ka5j/obd2-sniffer/docs/design/testing.md

# Testing and code coverage

Part of the [project documentation](../README.md).

## In short

Every change to this project is tested automatically before it can be merged. The logic that
doesn't depend on the microcontroller's hardware (data buffers, message encoding, the console,
the diagnostic protocol) is written so it can also run on a normal computer, where it is checked
by unit tests.

Those tests must reach **100% MC/DC coverage**, or the change is rejected. MC/DC is the coverage
standard used for flight-control software (DO-178C) and recommended for the highest safety level
of automotive software (ISO 26262 ASIL D). It means that for every decision in the code, each
condition in it was shown to change the outcome on its own. The tests also run under tools that
detect memory errors, undefined behaviour and race conditions between threads.

All C code is also checked against the MISRA C:2012 coding standard; see [misra.md](misra.md).
The firmware's worst-case stack use is worked out from each build and must fit the reserved
stack; see [build-and-boot.md](build-and-boot.md#memory-layout).

Results are published automatically:

- **Live report:** <https://ka5j.github.io/obd2-sniffer/>, with every test and the line-by-line
  coverage, updated on each merge
- **Pull requests:** each test appears in the checks tab, and a coverage table is added to the
  build summary

## What gets tested where

| Code | Runs on | How it is tested |
|---|---|---|
| Portable core (`lib/`): buffers, encoding, console logic, CAN timing, ISO-TP and OBD2 | Laptop and CI | Unit tests, 100% MC/DC required |
| Hardware drivers (`firmware/`): clocks, UART, CAN, watchdog | The STM32 board | On the board: `scripts/board_check.py`, deliberate crashes, and checks by hand |
| Laptop tool (`host/`) | Laptop and CI (Python 3.10 and 3.12) | Python tests (pytest), 100% line and branch coverage required, plus lint (ruff) |

Keeping hardware-specific code thin, and moving every decision that can be moved into the portable
core, is what makes the high coverage target practical.

The laptop tool is tested against a software model of the board's console (`host/src/obdsniff/sim/board.py`)
and against scripted fake connections for the failure cases: no reply, malformed replies, a
board that doesn't come back after a restart, a release build that rejects test commands. The
desktop app is tested the same way with pytest-qt: the real window is clicked through against the
simulator, drawing offscreen so it runs in CI without a display. Python has no MC/DC tooling, so
it is held to 100% line and branch coverage instead.

## Checks on the board

Code that drives the hardware can only be proven on the hardware. It is checked on a real
NUCLEO-F446RE board. Each release is checked this way before it is tagged.

Most checks are scripted in `scripts/board_check.py`. It drives the board through the laptop
tool's library and prints one line per check with the number it measured, so anyone with a board
can repeat the results below:

```sh
python3 scripts/board_check.py            # finds the board; about 75 s
python3 scripts/board_check.py --crash    # also the crash and watchdog checks (restarts the board)
python3 scripts/board_check.py --quick    # fewer frames, shorter waits; about 20 s
```

The latest run, on 2 November 2026, of CI's release file for v0.5.0, **Debug build**, flashed
onto the board by `scripts/release_check.py --flash debug`, with `--crash`:

```
Board check on /dev/cu.usbmodem11303
PASS  Identity        firmware v0.5.0, debug build, STM32F446RE rev 0x1000
PASS  Clocks          168 MHz from HSE 8 MHz bypass
PASS  Watchdog        500 ms nominal
PASS  Clock accuracy  -14 ppm against the laptop over 20 s (limit 1000)
PASS  Command burst   100 commands sent at once: 100 replies, 0 errors, nothing dropped; 26.9 KB in 180 ms (99% of the line rate)
PASS  CAN safety      with CAN off, 2 of 2 transmit commands refused; no command sends a frame by hand
PASS  CAN capture     100,000 frames at 500 kbit/s: 0 lost, 0 wrong, 0 damaged; 4,230 frames/s (a full bus gives at least 3,704)
PASS  CAN capture     10,000 frames at 250 kbit/s: 0 lost, 0 wrong, 0 damaged; 2,097 frames/s (a full bus gives at least 1,852)
PASS  CAN overload    20,000 frames at 1000 kbit/s: 2,444 lost; board counted 2,444 dropped and 0 overruns, laptop saw 2,444 missing capture numbers
PASS  OBD2            201 requests in 10 s (20.0/s, 15 to 20), 0 refused by the guard: 201 replies, 0 timeouts, 0 errors; VIN right, trouble codes right; then silent when not asked
PASS  CAN interrupt   longest receive interrupt 10 us (limit 47)
PASS  Commands + CAN  2,601 commands while 42,131 frames arrived at 500 kbit/s: 0 failed, 0 bytes lost to receive overruns
PASS  Reset           after `reset`: last reset software
PASS  Crash capture   `crash bus`: BusFault (bus error on data access) at 0x08002066
PASS  Crash capture   `crash usage`: UsageFault (unaligned memory access) at 0x08002172
PASS  Crash capture   `crash divzero`: UsageFault (divide by zero) at 0x0800219C
PASS  Crash capture   `crash hard`: HardFault (bus error on data access) at 0x08002066
PASS  Watchdog        main loop stopped: last reset independent watchdog
18 checks: all passed.
```

CI's **Release build** passed the same day, with three differences:

- **CAN overload:** 5,209 of 20,000 frames lost (the Debug build: 2,444), every one counted on
  the board and seen as a gap on the laptop. The test traffic comes from the same main loop that
  streams it, and only the optimised Release build keeps a 1 Mbit/s bus full while streaming, so
  overload numbers are quoted from the Release build.
- **CAN interrupt:** 6 µs at most, against 10 µs in the Debug build.
- **Crash command:** absent, as it should be; 14 checks in all.

The locally built tag passed the same checks before it was pushed (Release 14 of 14, Debug 18 of
18).

CI runs the same script against the simulator (`--port sim`) on every change, so it keeps working
as the code changes. The rest (the button, the LED, the desktop app, timing the watchdog) is
checked by hand.

**Latest full checks by hand:** 19 and 20 October 2026, for v0.4.0, Debug and Release builds,
serial link at 1.5 Mbaud. v0.4.1 changed no firmware behaviour, so for it, on 28 October 2026,
only `obdsniff can test`, `obdsniff obd watch` and the desktop app's console, CAN and OBD2 tabs
were repeated by hand, all passing. For v0.5.0, on 2 November 2026, the desktop app's three tabs
were driven on the board by `scripts/screenshots.py` (connect, `help`, `crash bus`, 10,000 test
frames, about 100 OBD2 questions), all as expected. The button, the LED heartbeat and the
watchdog's timing by stopwatch were not repeated by hand for v0.5.0.

| Area | Check | Result |
|---|---|---|
| Clocks | Start-up report shows the external 8 MHz clock, 180 MHz CPU, 45 and 90 MHz buses | Pass |
| Clocks | Board uptime against the laptop's clock over 20 s | Pass: +15 ppm, within the resolution of the measurement (1 ms in 20 s, 50 ppm). The internal oscillator would be off by up to 1% (10,000 ppm) |
| Serial console | Every command and error message; Backspace, Ctrl-C, the 96-character limit | Pass |
| Serial console | The reply to `reset` arrives complete before the board restarts | Pass |
| Serial console | Bursts of commands sent without waiting: 20 and 50 at 115200 baud, 100 at 1.5 Mbaud (28 KB at 99% of the line rate). Every reply intact, nothing dropped, no restart | Pass |
| Serial console | Commands sent continuously while the CAN bus is full (500 kbit/s): 2,693 commands as 42,129 frames arrived, none failed, no received byte lost | Pass |
| Button and LED | Button presses reported in both modes, with a half-typed line shown again; LED heartbeat | Pass |
| Crash capture | `crash bus`, `usage`, `divzero`, `hard`: right fault type and cause after the restart; the saved code address points at the faulting line (`fault.c:87` for `bus`); bad address `0x08080000` | Pass |
| Watchdog | Main loop stopped on purpose: reset after 535 ms (allowed: 340 to 940 ms), reported as a watchdog reset | Pass |
| Reset causes | Software reset, watchdog and reset pin each reported correctly | Pass |
| Release build | The `crash` test command is absent; everything else works | Pass |
| Laptop tool | Board found by its USB IDs; `info`, `--json status`, `led`, `shell` reconnecting after `reset` and `crash` | Pass |
| Desktop app | Connect, board details, console commands, `crash bus` then clear the record; the window keeps responding while the board restarts; the board is handed back in interactive mode on exit | Pass |
| Serial link | Stress test at 921,600, 1,000,000, 1,500,000 and 2,250,000 baud: every reply intact, about 99% of the line rate, no errors; 1.5 Mbaud chosen ([serial-console.md](serial-console.md#speed)) | Pass |
| CAN capture | Silent loopback, every frame checked by number and content: 100,000 frames at 500 kbit/s (4,230 frames/s, 100% load) and 10,000 at 250 kbit/s, none lost or damaged; frame spacing matches the frame length on the bus | Pass |
| CAN capture | 1 Mbit/s overload: frames dropped on the board when the serial link can't keep up, and the laptop sees exactly that many gaps in the capture numbers | Pass |
| CAN capture | Longest receive interrupt: 7 µs | Pass |
| CAN capture | Streaming off (`can stream off`): no frame lines in a terminal during 1,000 test frames, all of them received and counted. At 1 Mbit/s and 100% load, 20,000 frames received and none dropped: the serial link is the only limit | Pass |
| OBD2 | Tester and simulated ECU over loopback, in a serial terminal: refused with CAN off; after 2 s, 220 requests and 220 replies; VIN (a multi-frame reply), both trouble codes and the warning light right; live values follow the simulated drive; about 95 requests a second; 0 timeouts, 0 errors, 0 frames dropped; longest receive interrupt 10 µs. Now also scripted in `board_check.py` | Pass |
| CAN tools | `can test`, `monitor --log` (candump file), shell; desktop-app CAN tab: 4,000 test frames shown, none lost; a second program can't open the port | Pass |

The checks found problems that the unit tests and the simulator had not, all fixed:

- A line longer than 96 characters was cut short and then run as a command. It is now rejected
  whole ([#16](https://github.com/ka5j/obd2-sniffer/pull/16)).
- The laptop tool left the board in host mode, so a serial terminal opened afterwards showed no
  prompt or echo ([#15](https://github.com/ka5j/obd2-sniffer/pull/15)).
- In `help` and `fault` output, the longest entries were out of alignment
  ([#16](https://github.com/ka5j/obd2-sniffer/pull/16)).
- A burst of commands (for example pasted into a terminal) ran in a single pass of the main loop.
  At 115200 baud the replies took over a second to send, so the watchdog restarted the board; with
  that fixed, replies were partly dropped because the transmit buffer freed space only in large
  steps. Commands now run one per pass, only when their reply fits, and DMA transfers are capped at
  256 bytes ([#24](https://github.com/ka5j/obd2-sniffer/pull/24)).
- At 1.5 Mbaud the laptop tool got no replies, although a hand-written test worked. Changing any
  serial setting makes pyserial re-apply them all, and on macOS 1.5 Mbaud is applied through a
  placeholder speed, so every read briefly switched the ST-LINK's speed and lost bytes. The port is
  now configured once ([#26](https://github.com/ka5j/obd2-sniffer/pull/26)).
- Frame sequence numbers were first given when frames were sent, so frames dropped on the board
  left no gap. The overload test showed no gaps while thousands of frames were lost. They are now
  numbered on arrival ([#29](https://github.com/ka5j/obd2-sniffer/pull/29)).
- Two programs could open the board's port at once and split its output between them. The laptop
  tool now opens it exclusively ([#30](https://github.com/ka5j/obd2-sniffer/pull/30)).
- With OBD2 running, about one command in 200 from the desktop app was rejected as an unknown
  command. Bytes were being lost on the way in: the board counted receive overruns, and only
  while CAN traffic ran. At 1.5 Mbaud the UART must be read within 6.7 µs of each byte, but the
  CAN receive interrupt, which then had the higher priority, can run for 7 to 10 µs. Interrupt
  priorities now follow deadlines, with the serial receive interrupt first. 20 s of commands
  during OBD2 traffic went from 11 overruns and 15 failed commands to none, and the board check
  now sends commands while the bus is full ([#46](https://github.com/ka5j/obd2-sniffer/pull/46)).

## Coverage measures

| Measure | Meaning |
|---|---|
| Lines | Every line ran in at least one test |
| Functions | Every function was called |
| Regions | Every block of code ran, including each part of a short-circuit expression |
| Branches | Every decision went both ways (true and false) |
| MC/DC | Every condition in a decision independently changed the decision's outcome |

Example: `if (rb == NULL || storage == NULL || capacity < 2 || !power_of_two)`. Branch coverage
only needs one test that rejects and one that accepts. MC/DC needs a test for each of the four
conditions, where only that condition is true and it alone causes the rejection. That proves
every check is actually needed and actually works.

## Engineering detail

### Tools

- **Unity**: a small C unit-test framework, fetched by CMake at a pinned version.
- **CTest**: CMake's test runner. Every Unity test function is registered as its own CTest test
  (`ring_buffer.test_counters_wrap_past_uint32_max`), so each case is reported individually.
  Unity's default `RUN_TEST` ignores the name filter, so the tests use a `UNIT_TEST()` wrapper
  that applies it (`tests/test_support.h`).
- **Clang source-based coverage** with `-fcoverage-mcdc` (Clang 18 or newer).
  `scripts/coverage.py` merges the results, writes the HTML report, and fails the build if any of
  the five measures is below 100%.
- **Sanitizers** on every test run:
  - *AddressSanitizer*: out-of-bounds access, use-after-free
  - *UndefinedBehaviorSanitizer*: integer overflow, misaligned access, invalid shifts
  - *ThreadSanitizer*: data races. This matters for the lock-free ring buffer, whose stress test
    runs a producer and a consumer thread at full speed.

  Any sanitizer finding stops the test immediately (`-fno-sanitize-recover=all`).

### Checking the checks

A test suite is only useful if it can fail, so each guard was verified by breaking the code on
purpose:

- **Coverage gate:** when it was introduced (the library then held only the ring buffer), skipping
  the one test of `ring_init`'s argument checks dropped MC/DC to 0% and branch coverage to 80%, and
  the gate failed.
- **ThreadSanitizer:** weakening the ring buffer's memory ordering from release/acquire to relaxed
  makes the CI run report `data race ... in memcpy`.
- **Name filter:** a test name that matches nothing makes Unity report "0 Tests", which CTest
  treats as a failure.

ThreadSanitizer is checked on Linux in CI. On current macOS it misses even a textbook race, so a
local pass there is not taken as evidence.

### Running locally

```sh
# Unit tests with AddressSanitizer + UndefinedBehaviorSanitizer (configure, build, run)
cmake --workflow --preset host-tests

# Coverage report (Clang 18+), opens build/host-coverage/report/coverage/index.html
cmake --preset host-coverage && cmake --build --preset host-coverage
ctest --preset host-coverage && python3 scripts/coverage.py

# Report site as published on GitHub Pages
python3 scripts/build_report_site.py --out build/site \
    --junit "C unit tests=build/host-coverage/junit-c.xml" \
    --coverage "C core library=build/host-coverage/report"
```
