ka5j/obd2-sniffer/hardware/rev-a/obd2-sniffer-rev-a.pdf

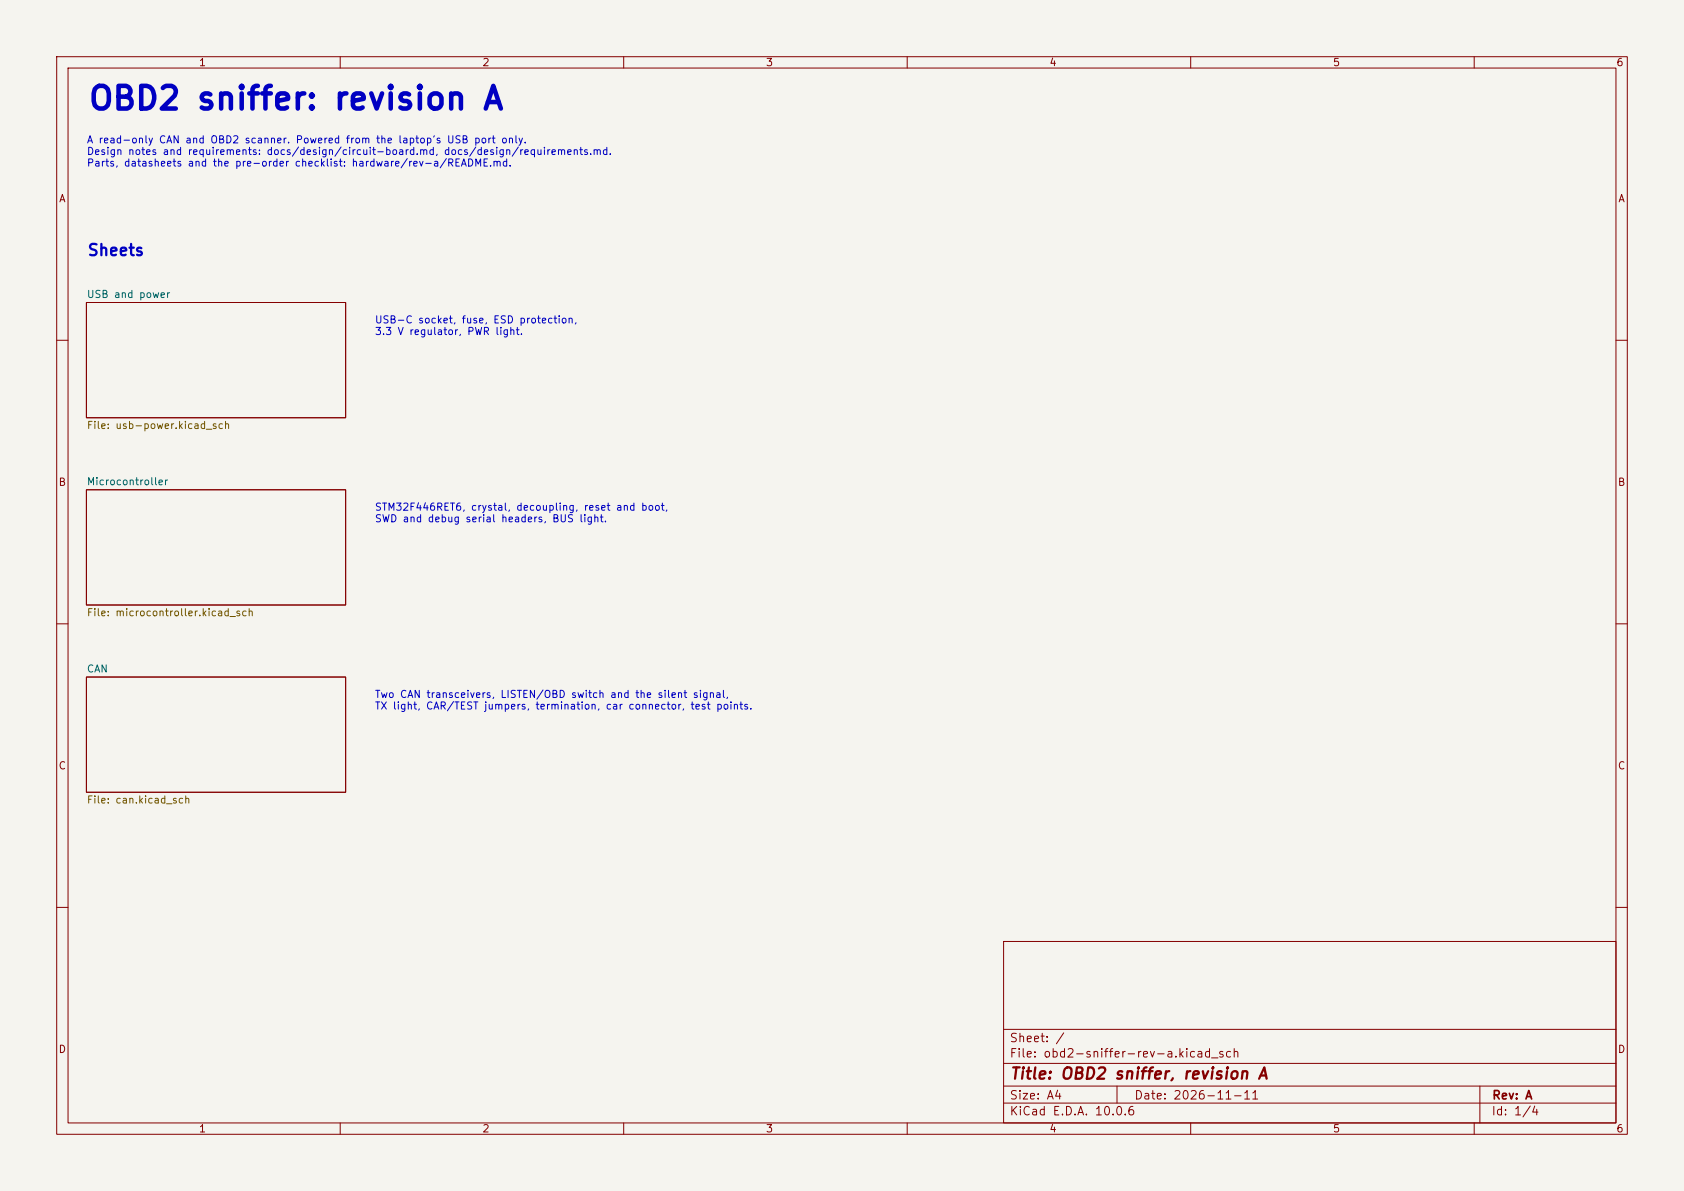
[picture p5: page 1]

USB and power File: usb-power.kicad_sch CAN

A read-only CAN and OBD2 scanner. Powered from the laptop's USB port only.
Design notes and requirements: docs/design/circuit-board.md, docs/design/requirements.md.
Parts, datasheets and the pre-order checklist: hardware/rev-a/README.md.

STM32F446RET6, crystal, decoupling, reset and boot, SWD and debug serial headers, BUS light. Two CAN transceivers, LISTEN/OBD switch and the silent signal, TX light, CAR/TEST jumpers, termination, car connector, test points.

Size: A4 | Rev: A
KiCad E.D.A. 10.0.6 | Id: 1/4

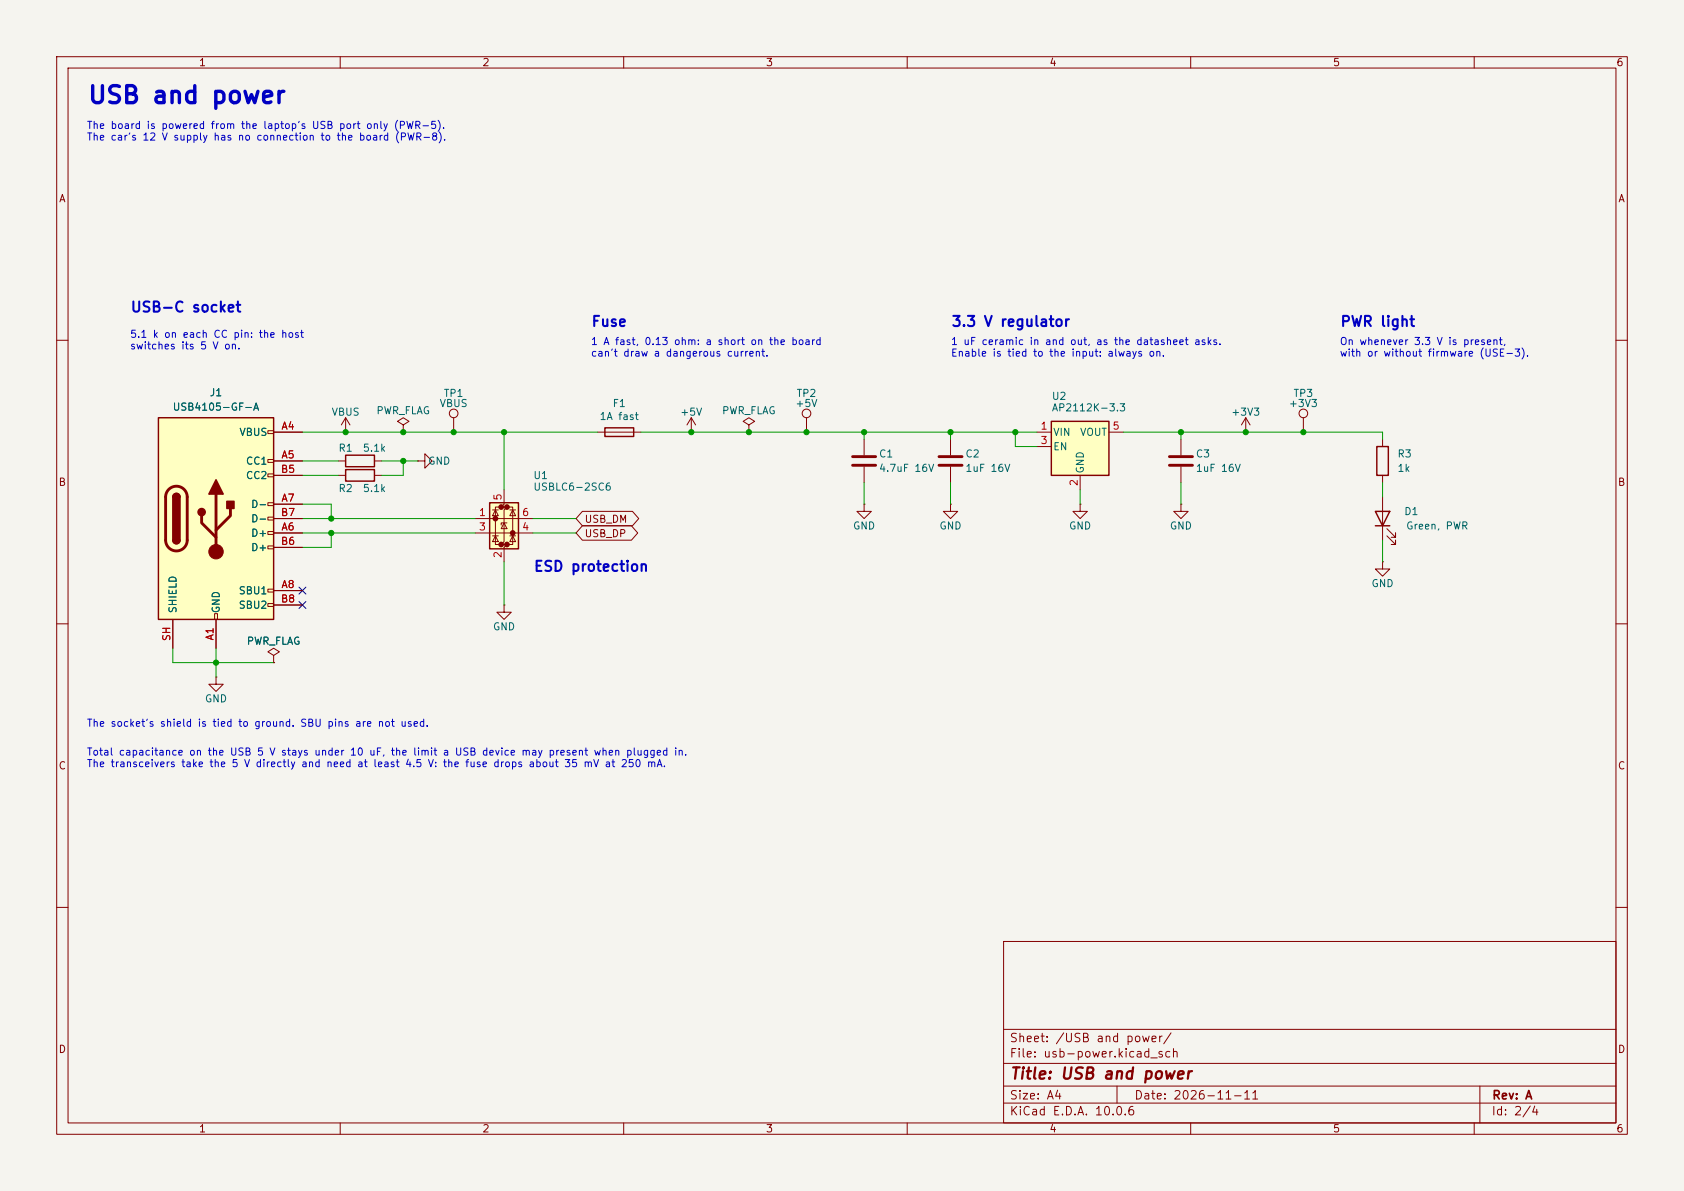
[picture p6: page 2]

The board is powered from the laptop's USB port only (PWR-5). The car's 12 V supply has no connection to the board (PWR-8).

5.1 k on each CC pin: the host switches its 5 V on. USB-C socket

can't draw a dangerous current. Fuse

1 A fast, 0.13 ohm: a short on the board

Sheet: /USB and power/ GND A1

File: usb-power.kicad_sch
Title: USB and power

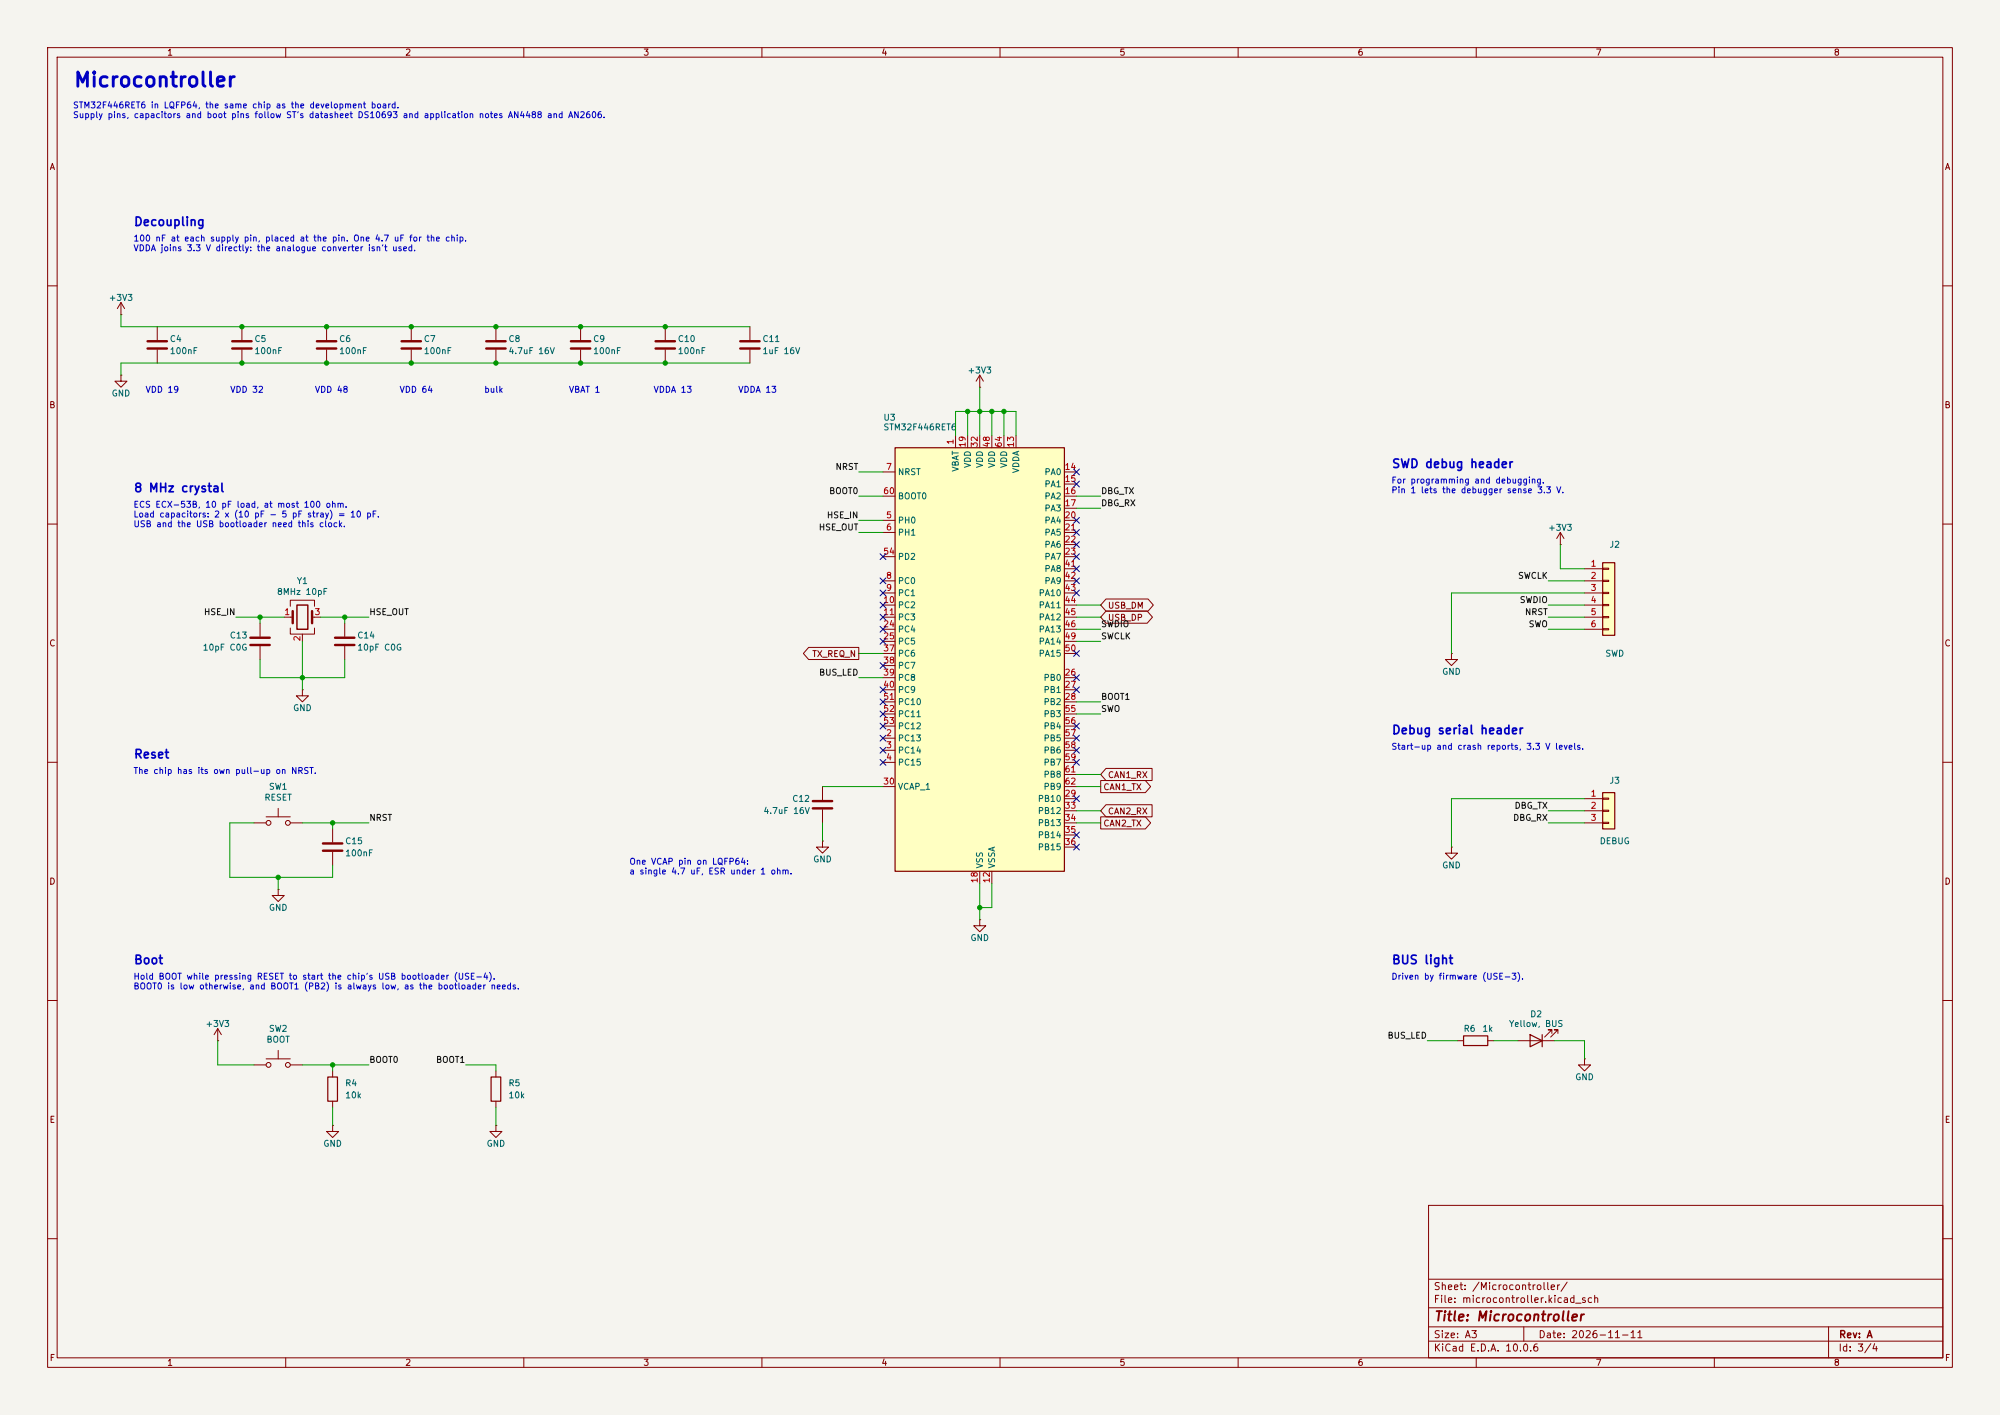
[picture p7: page 3]

The chip has its own pull-up on NRST. Microcontroller

100 nF at each supply pin, placed at the pin. One 4.7 uF for the chip. VDDA joins 3.3 V directly: the analogue converter isn't used. Decoupling

For programming and debugging. Pin 1 lets the debugger sense 3.3 V. Reset

Start-up and crash reports, 3.3 V levels. Debug serial header

Boot Hold BOOT while pressing RESET to start the chip's USB bootloader (USE-4). BOOT0 is low otherwise, and BOOT1 (PB2) is always low, as the bootloader needs.

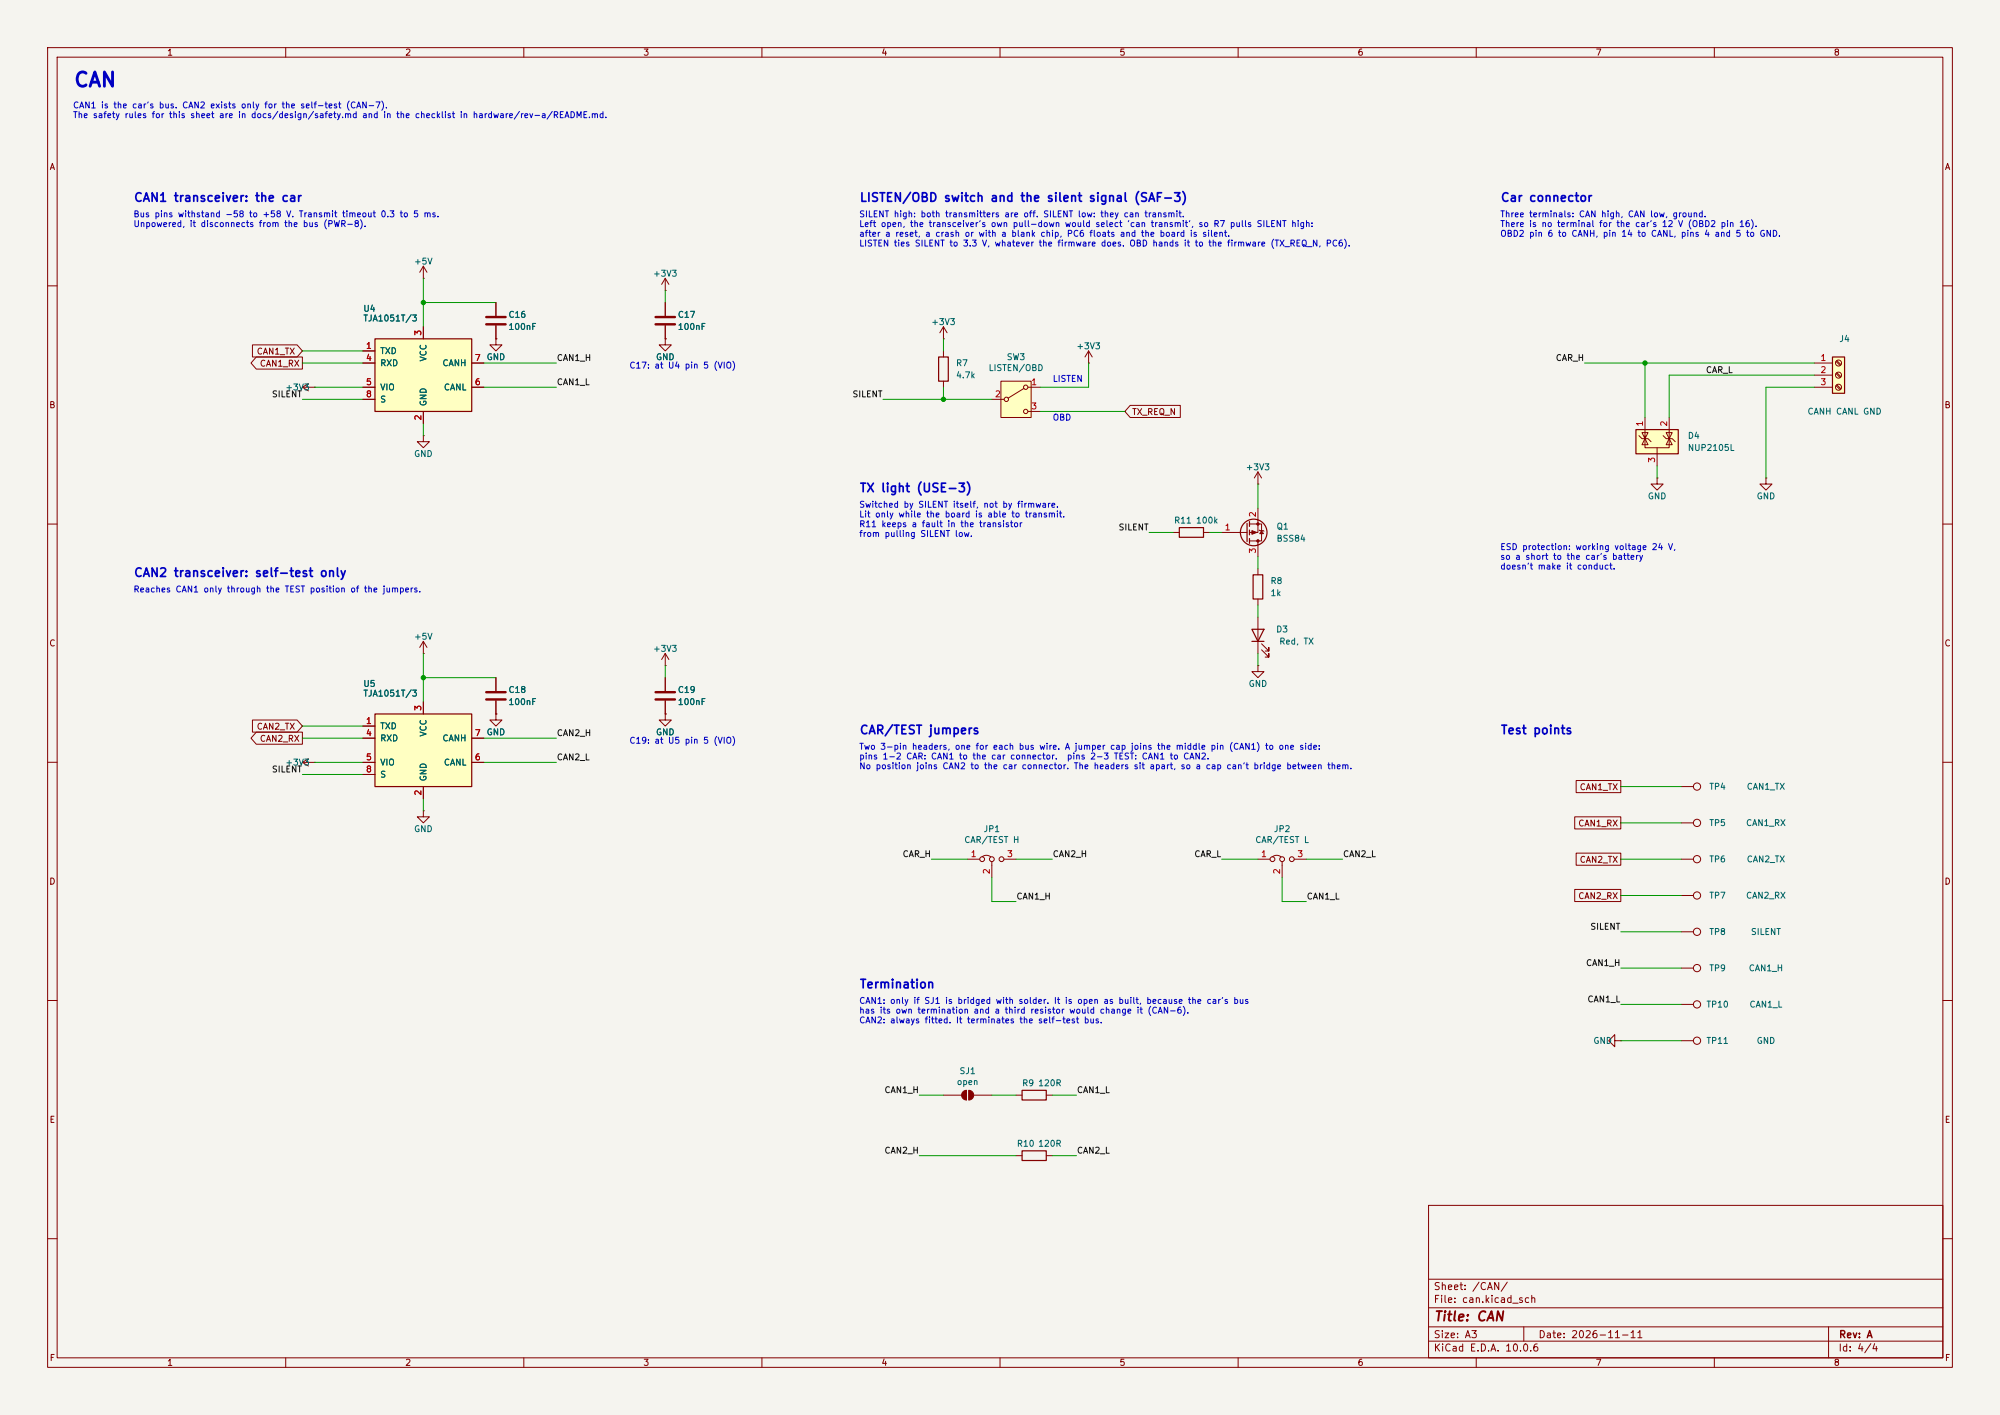
[picture p8: page 4]

CAN1 transceiver: the car CAN1 is the car's bus. CAN2 exists only for the self-test (CAN-7). The safety rules for this sheet are in docs/design/safety.md and in the checklist in hardware/rev-a/README.md. Bus pins withstand -58 to +58 V. Transmit timeout 0.3 to 5 ms. Unpowered, it disconnects from the bus (PWR-8).U4

ESD protection: working voltage 24 V, so a short to the car's battery doesn't make it conduct. Car connector

from pulling SILENT low. LISTEN/OBD switch and the silent signal (SAF-3) SILENT high: both transmitters are off. SILENT low: they can transmit. Left open, the transceiver's own pull-down would select 'can transmit', so R7 pulls SILENT high: after a reset, a crash or with a blank chip, PC6 floats and the board is silent. LISTEN ties SILENT to 3.3 V, whatever the firmware does. OBD hands it to the firmware (TX_REQ_N, PC6). OBD

Three terminals: CAN high, CAN low, ground. There is no terminal for the car's 12 V (OBD2 pin 16). OBD2 pin 6 to CANH, pin 14 to CANL, pins 4 and 5 to GND.

Switched by SILENT itself, not by firmware. Lit only while the board is able to transmit. R11 keeps a fault in the transistor

CAN2 transceiver: self-test only

Two 3-pin headers, one for each bus wire. A jumper cap joins the middle pin (CAN1) to one side: pins 1-2 CAR: CAN1 to the car connector. pins 2-3 TEST: CAN1 to CAN2. No position joins CAN2 to the car connector. The headers sit apart, so a cap can't bridge between them. Reaches CAN1 only through the TEST position of the jumpers.

CAN1: only if SJ1 is bridged with solder. It is open as built, because the car's bus has its own termination and a third resistor would change it (CAN-6). CAN2: always fitted. It terminates the self-test bus. CAR/TEST jumpers
