ka5j/obd2-sniffer/hardware/rev-a/microcontroller.kicad_sch

## KiCad design hardware/rev-a/microcontroller.kicad_sch (2026-11-13)

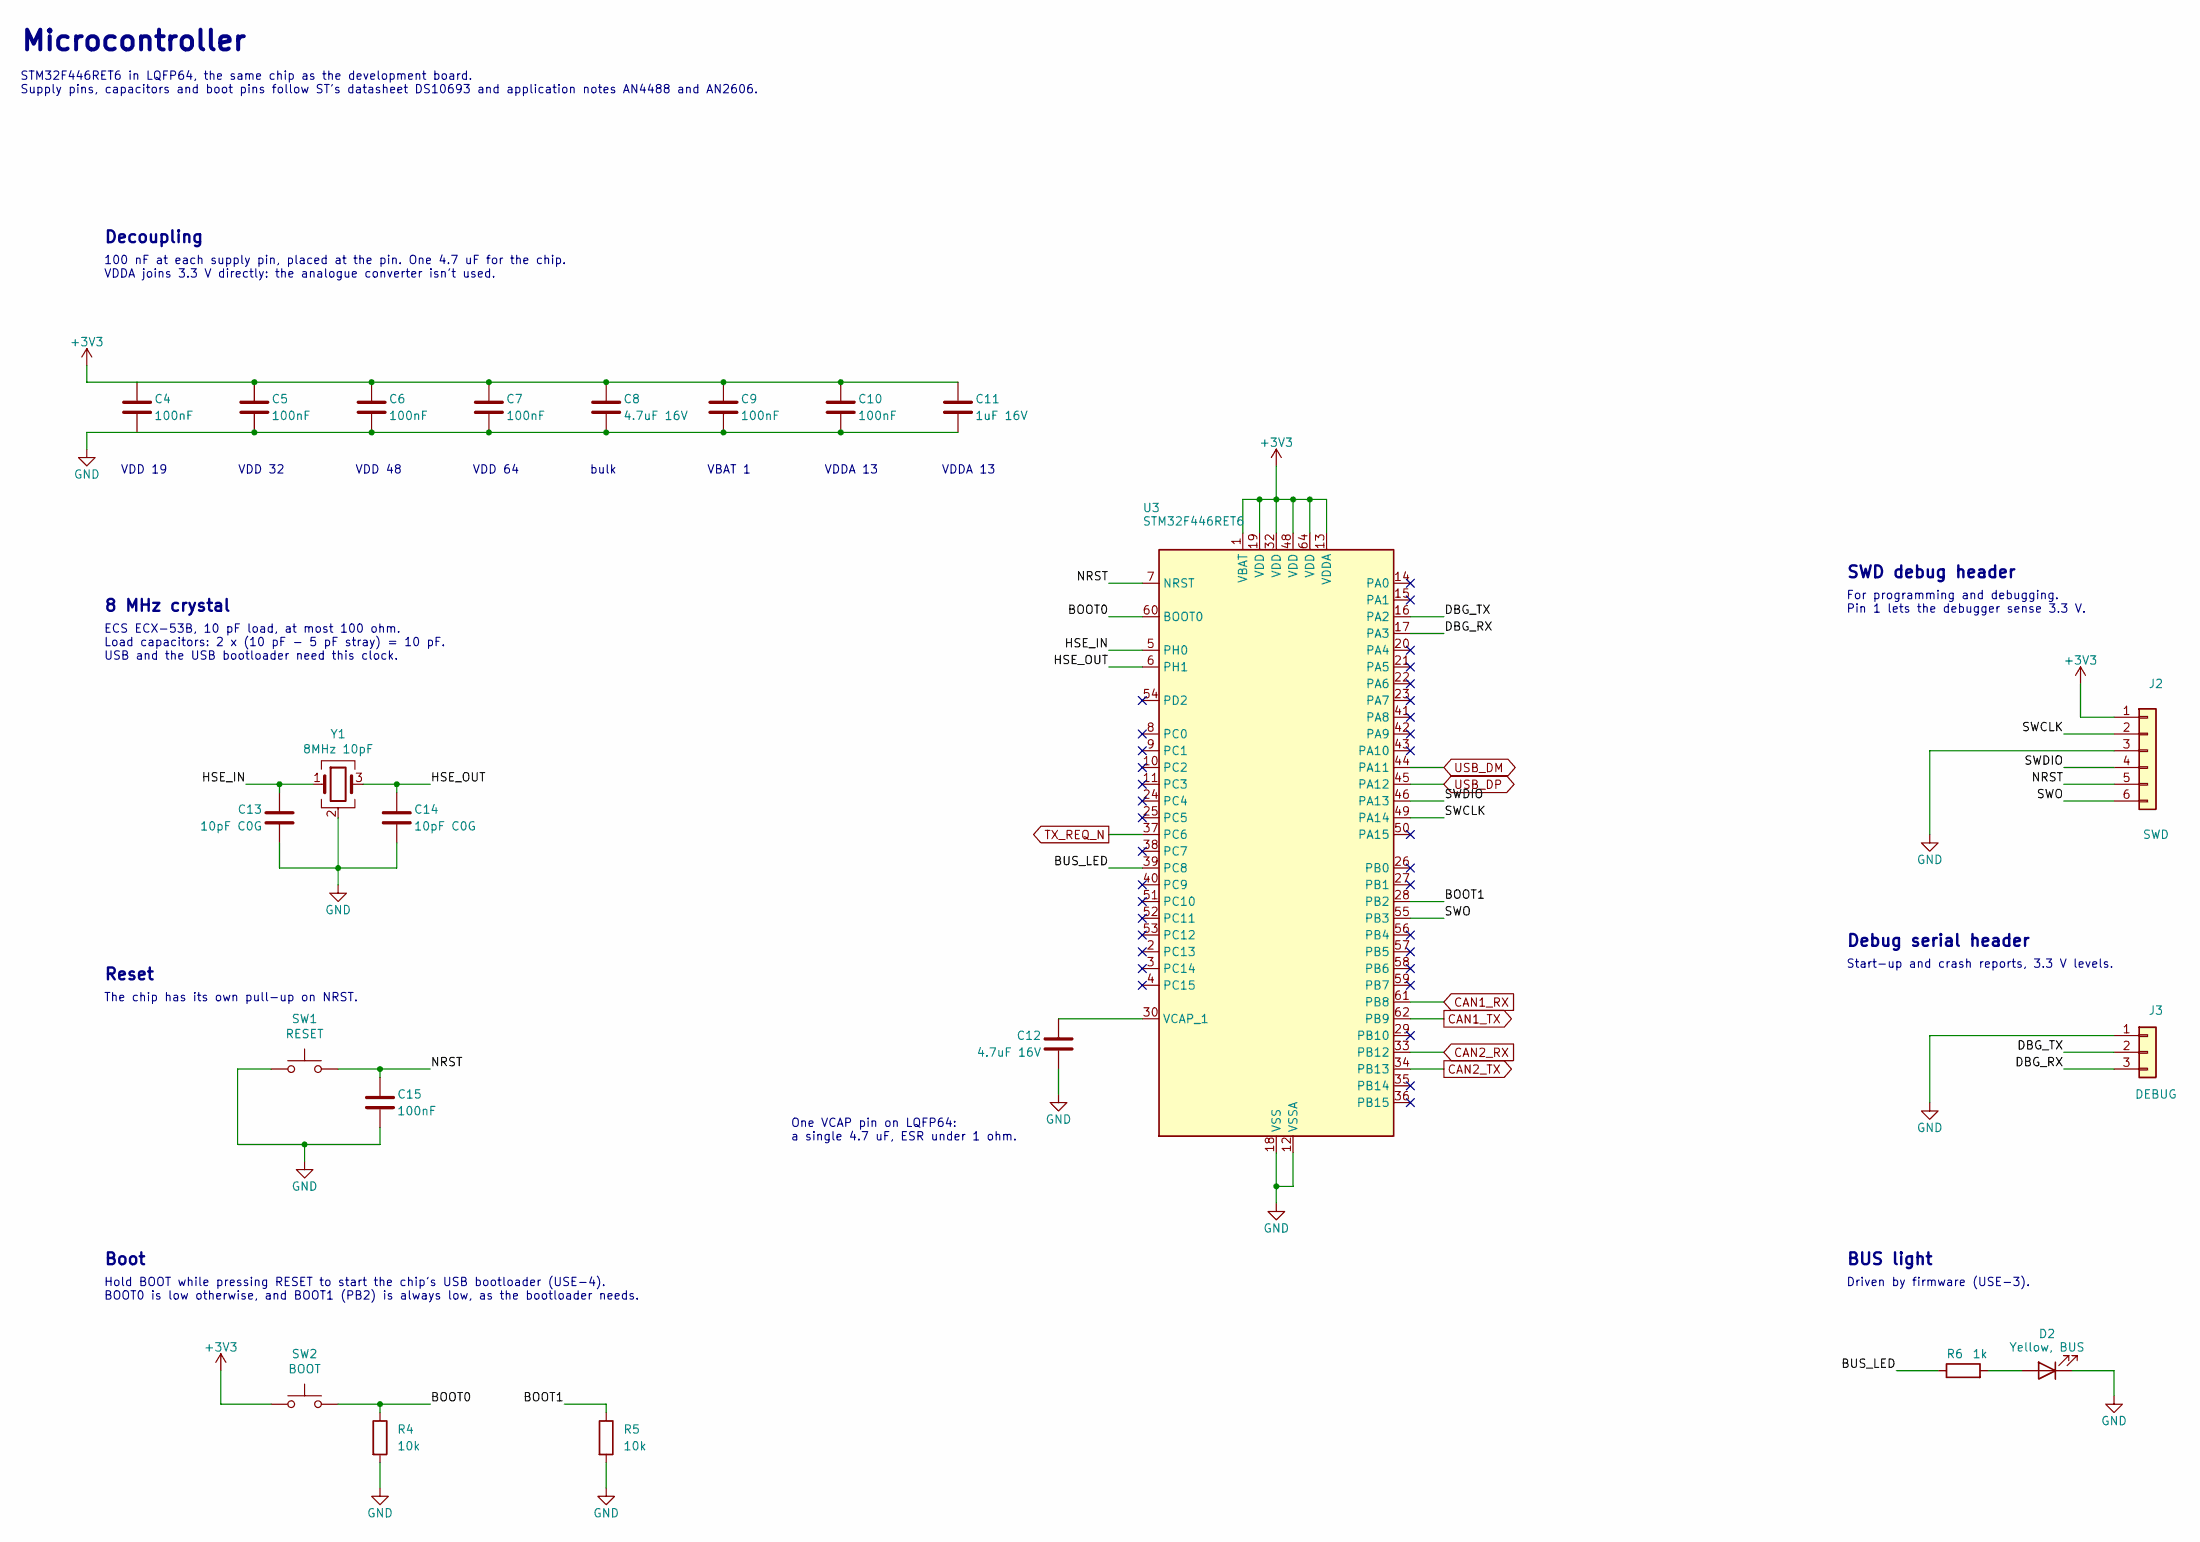
[picture p9: schematic microcontroller.kicad_sch]

Parts:
C4, C5, C6, C7, C9, C10, C15: 100nF; C_0603_1608Metric
C8, C12: 4.7uF 16V; C_0805_2012Metric
C11: 1uF 16V; C_0603_1608Metric
C13, C14: 10pF C0G; C_0603_1608Metric
D2: Yellow, BUS; LED_0603_1608Metric
J2: SWD; PinHeader_1x06_P2.54mm_Vertical
J3: DEBUG; PinHeader_1x03_P2.54mm_Vertical
R4, R5: 10k; R_0603_1608Metric
R6: 1k; R_0603_1608Metric
SW1: RESET; SW_SPST_PTS645Sx43SMTR92
SW2: BOOT; SW_SPST_PTS645Sx43SMTR92
U3: STM32F446RET6; LQFP-64_10x10mm_P0.5mm; MPN STM32F446RET6
Y1: 8MHz 10pF; Crystal_SMD_5032-4Pin_5.0x3.2mm; MPN ECS-80-10-30B-TR

Connections:
+3V3: C4.1, C5.1, C6.1, C7.1, C8.1, C9.1, C10.1, C11.1, J2.1, SW2.1, U3.1 (VBAT), U3.13 (VDDA), U3.19 (VDD), U3.32 (VDD), U3.48 (VDD), U3.64 (VDD)
BOOT0: R4.1, SW2.2, U3.60 (BOOT0)
BOOT1: R5.1, U3.28 (PB2)
BUS_LED: R6.1, U3.39 (PC8)
CAN1_RX: U3.61 (PB8)
CAN1_TX: U3.62 (PB9)
CAN2_RX: U3.33 (PB12)
CAN2_TX: U3.34 (PB13)
DBG_RX: J3.3, U3.17 (PA3)
DBG_TX: J3.2, U3.16 (PA2)
GND: C4.2, C5.2, C6.2, C7.2, C8.2, C9.2, C10.2, C11.2, C12.2, C13.2, C14.2, C15.2, D2.1 (K), J2.3, J3.1, R4.2, R5.2, SW1.1, U3.12 (VSSA), U3.18 (VSS), U3.31 (VSS), U3.47 (VSS), U3.63 (VSS), Y1.2 (G), Y1.4 (G)
HSE_IN: C13.1, U3.5 (PH0), Y1.1
HSE_OUT: C14.1, U3.6 (PH1), Y1.3
NRST: C15.1, J2.5, SW1.2, U3.7 (NRST)
unnamed: C12.1, U3.30 (VCAP_1)
unnamed: D2.2 (A), R6.2
SWCLK: J2.2, U3.49 (PA14)
SWDIO: J2.4, U3.46 (PA13)
SWO: J2.6, U3.55 (PB3)
TX_REQ_N: U3.37 (PC6)
USB_DM: U3.44 (PA11)
USB_DP: U3.45 (PA12)

Notes on the sheet:
Microcontroller
Decoupling
VDDA 13
VDD 64
bulk
Reset
Boot
8 MHz crystal
VDD 48
VDD 19
One VCAP pin on LQFP64: a single 4.7 uF, ESR under 1 ohm.
BUS light
100 nF at each supply pin, placed at the pin. One 4.7 uF for the chip. VDDA joins 3.3 V directly: the analogue converter isn't used.
VBAT 1
For programming and debugging. Pin 1 lets the debugger sense 3.3 V.
STM32F446RET6 in LQFP64, the same chip as the development board. Supply pins, capacitors and boot pins follow ST's datasheet DS10693 and application notes AN4488 and AN2606.
SWD debug header
Hold BOOT while pressing RESET to start the chip's USB bootloader (USE-4). BOOT0 is low otherwise, and BOOT1 (PB2) is always low, as the bootloader needs.
Start-up and crash reports, 3.3 V levels.
VDD 32
Driven by firmware (USE-3).
The chip has its own pull-up on NRST.
Debug serial header
ECS ECX-53B, 10 pF load, at most 100 ohm. Load capacitors: 2 x (10 pF - 5 pF stray) = 10 pF. USB and the USB bootloader need this clock.
