ka5j/obd2-sniffer/hardware/rev-a/usb-power.kicad_sch

## KiCad design hardware/rev-a/usb-power.kicad_sch (2026-11-12)

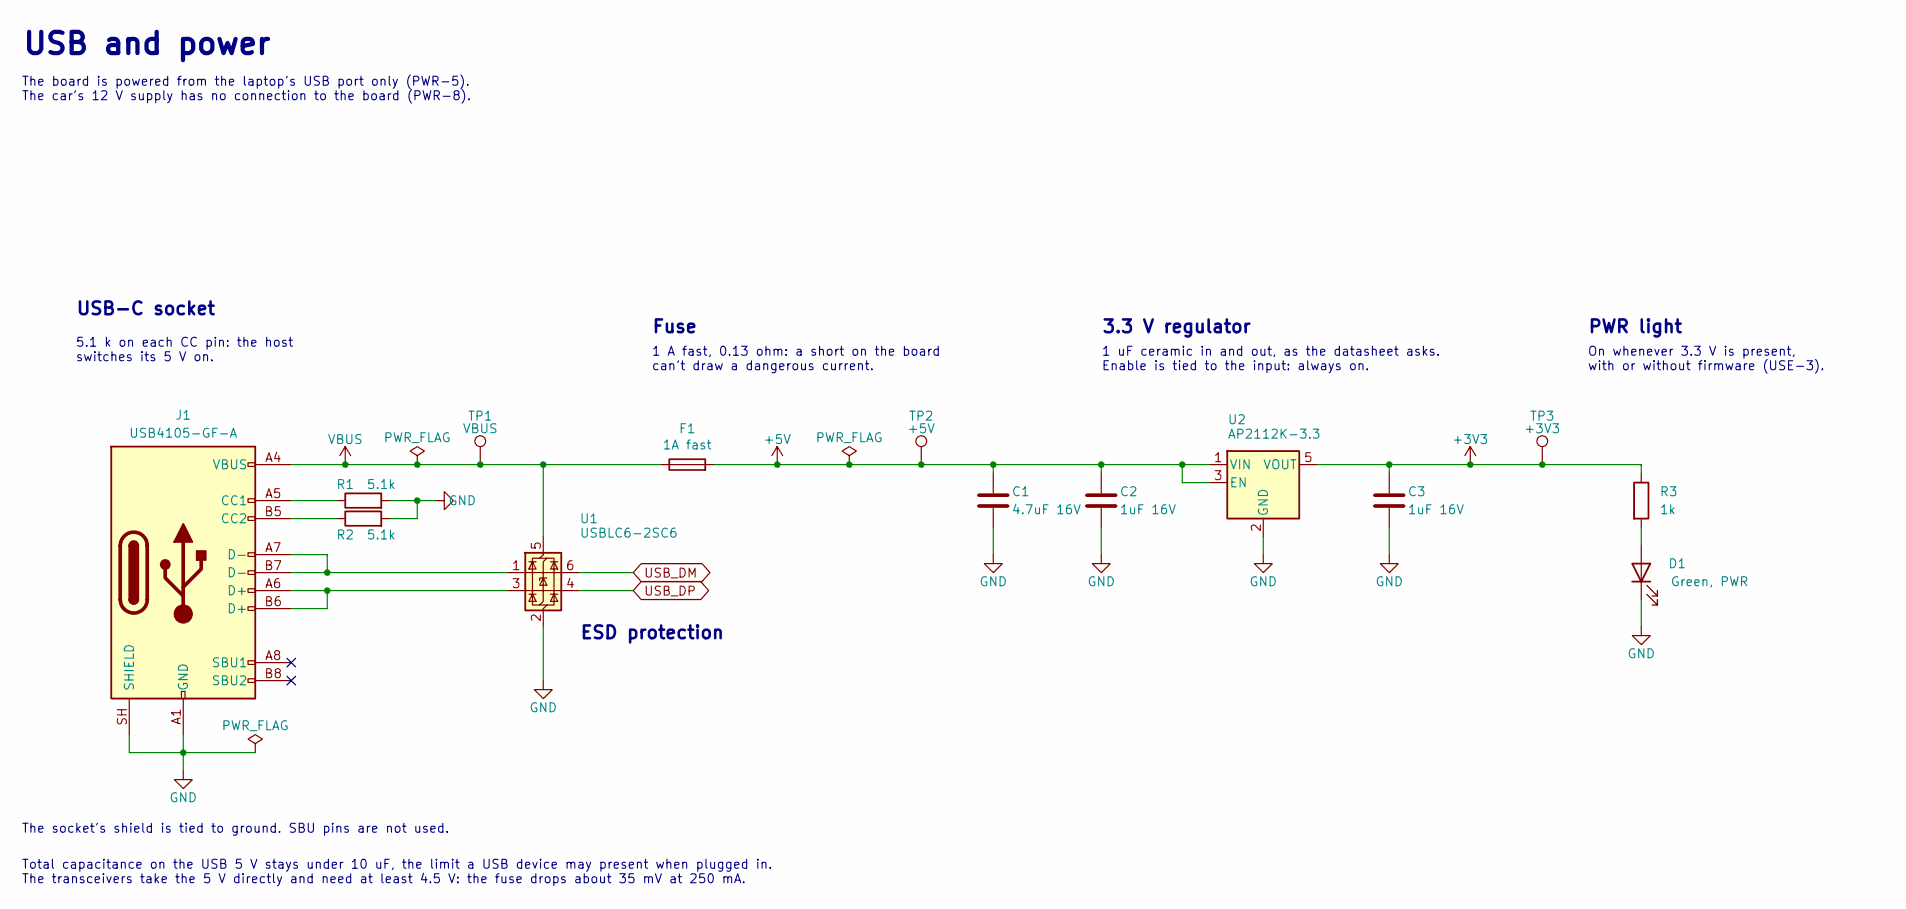
[picture p10: schematic usb-power.kicad_sch]

Parts:
C1: 4.7uF 16V; C_0805_2012Metric
C2, C3: 1uF 16V; C_0603_1608Metric
D1: Green, PWR; LED_0603_1608Metric
F1: 1A fast; Fuse_1206_3216Metric; MPN SF-1206F100-2
J1: USB4105-GF-A; USB_C_Receptacle_GCT_USB4105-xx-A_16P_TopMnt_Horizontal; MPN USB4105-GF-A
R1, R2: 5.1k; R_0603_1608Metric
R3: 1k; R_0603_1608Metric
TP1: VBUS; TestPoint_Pad_D1.5mm
TP2: +5V; TestPoint_Pad_D1.5mm
TP3: +3V3; TestPoint_Pad_D1.5mm
U1: USBLC6-2SC6; SOT-23-6; MPN USBLC6-2SC6
U2: AP2112K-3.3; SOT-23-5; MPN AP2112K-3.3TRG1

Connections:
+3V3: C3.1, R3.1, TP3.1, U2.5 (VOUT)
+5V: C1.1, C2.1, F1.2, TP2.1, U2.1 (VIN), U2.3 (EN)
GND: C1.2, C2.2, C3.2, D1.1 (K), J1.A1 (GND), J1.A12 (GND), J1.B1 (GND), J1.B12 (GND), J1.SH (SHIELD), R1.2, R2.2, U1.2 (GND), U2.2 (GND)
unnamed: D1.2 (A), R3.2
unnamed: J1.A5 (CC1), R1.1
unnamed: J1.A6 (D+), J1.B6 (D+), U1.3 (I/O2)
unnamed: J1.A7 (D-), J1.B7 (D-), U1.1 (I/O1)
unnamed: J1.B5 (CC2), R2.1
USB_DM: U1.6 (I/O1)
USB_DP: U1.4 (I/O2)
VBUS: F1.1, J1.A4 (VBUS), J1.A9 (VBUS), J1.B4 (VBUS), J1.B9 (VBUS), TP1.1, U1.5 (VBUS)

Notes on the sheet:
The board is powered from the laptop's USB port only (PWR-5). The car's 12 V supply has no connection to the board (PWR-8).
Total capacitance on the USB 5 V stays under 10 uF, the limit a USB device may present when plugged in. The transceivers take the 5 V directly and need at least 4.5 V: the fuse drops about 35 mV at 250 mA.
On whenever 3.3 V is present, with or without firmware (USE-3).
ESD protection
USB and power
PWR light
USB-C socket
5.1 k on each CC pin: the host switches its 5 V on.
The socket's shield is tied to ground. SBU pins are not used.
1 A fast, 0.13 ohm: a short on the board can't draw a dangerous current.
1 uF ceramic in and out, as the datasheet asks. Enable is tied to the input: always on.
Fuse
3.3 V regulator
