ka5j/obd2-sniffer/firmware/include/can_stream.h

/*
 * Sends received CAN frames to the laptop: one binary packet each in host
 * mode (lib/packet), one readable line each in interactive mode
 * (lib/can_text).
 *
 * It never waits for the serial link. A frame is only taken from the receive
 * queue once its output fits in the transmit buffer beyond the space kept
 * for command replies (CONSOLE_REPLY_SPACE), so commands stay responsive
 * while traffic streams. If the link can't keep up, frames wait in the
 * queue; if the queue fills up, the receive interrupt counts them as
 * dropped.
 *
 * Streaming can be switched off (`can stream off`), for example so that a
 * person in a serial terminal isn't flooded while the board talks OBD2.
 * Frames are then still received and counted, but not sent.
 */
#ifndef CAN_STREAM_H
#define CAN_STREAM_H

#include <stdbool.h>
#include <stdint.h>

/* Main loop: send what fits. */
void can_stream_task(uint32_t now_ms);

/* Frames sent to the laptop since start-up. */
uint32_t can_stream_sent(void);

/* Streaming on or off. On at start-up. */
void can_stream_enable(bool on);
bool can_stream_enabled(void);

#endif /* CAN_STREAM_H */
