ka5j/obd2-sniffer/host/src/obdsniff/shell.py

"""Interactive session with the board from the laptop.

Type the board's commands; the laptop tool sends them, formats the
replies, shows events and frames as they arrive, and handles restarts
(`reset`, `crash`) by reconnecting.
"""

from __future__ import annotations

from collections.abc import Callable

from obdsniff.device import CommandError, Device, ProtocolError
from obdsniff.output import format_fields, format_reply
from obdsniff.packets import TimestampUnwrapper, format_frame

BANNER = "Connected. Type board commands (try 'help'); 'exit' or Ctrl-D quits."
MAX_FRAMES_SHOWN = 20  # more than this between prompts is summarised


def execute_line(device: Device, line: str) -> list[str]:
    """Run one line typed by a person and return the rows to show.

    Board commands are passed through and their replies formatted. `reset`
    and `crash <kind>` also wait for the board to restart and reconnect. Raises
    CommandError or ProtocolError like Device.command(). Used by the shell
    and the desktop app's console."""
    words = line.split()
    name = words[0].lower()
    if name == "reset":
        device.reset()
        return ["Board restarted."]
    if name == "crash" and len(words) == 2:
        device.crash(words[1])
        return [
            "Board restarted after the crash. What it recorded:",
            *format_fields(device.fault()),
        ]
    return format_reply(device.command(line))


def run_shell(
    device: Device,
    read_line: Callable[[str], str] = input,
    write: Callable[[str], None] = print,
) -> int:
    write(BANNER)
    clock = TimestampUnwrapper()
    while True:
        for event in device.poll_events():
            write(f"[event] {event}")
        frames = device.poll_frames()
        for frame in frames[:MAX_FRAMES_SHOWN]:
            write(format_frame(frame, clock.seconds(frame.timestamp_us)))
        if len(frames) > MAX_FRAMES_SHOWN:
            more = len(frames) - MAX_FRAMES_SHOWN
            write(f"  ... and {more} more frames (`obdsniff monitor` shows them all)")
        try:
            line = read_line("obd> ").strip()
        except (EOFError, KeyboardInterrupt):
            write("")
            return 0
        if not line:
            continue
        if line.lower() in ("exit", "quit"):
            return 0
        try:
            for row in execute_line(device, line):
                write(row)
        except CommandError as exc:
            write(f"error: {exc.reason}")
        except ProtocolError as exc:
            write(f"error: {exc}")
