ka5j/obd2-sniffer/(commit log)

2026-10-18 feat(build): add CMake cross-build for STM32F446RE with HAL submodules (#1)
    - arm-none-eabi toolchain file (Cortex-M4F, hard-float, newlib-nano)
    - CMake presets for debug and size-optimised firmware builds
    - ST HAL, CMSIS device and CMSIS core as pinned git submodules
    (hal-driver v1.8.5, cmsis-device-f4 v2.6.11, cmsis-core v5.9.0_20250520)
    - Hand-written linker script with .noinit section and stack-size guard
    - Trimmed HAL config enabling only the modules the project uses
    - Build-time version header from `git describe`
    - Post-build .bin/.hex + size report, OpenOCD `flash` target
    - Minimal board support and non-blocking LED heartbeat
2026-10-18 feat(core): 180 MHz clock tree, UART console and boot banner (#3)
    * feat(core): 180 MHz clock tree, UART console and boot banner
    - Clock: HSE 8 MHz bypass -> PLL -> 180 MHz with over-drive, APB1 45 MHz,
    APB2 90 MHz; falls back to HSI if HSE fails to start
    - Console on USART2 (ST-LINK VCP), heap-free console_printf via vsnprintf
    - Reset cause read from RCC_CSR and reported at boot
    - Boot banner: firmware version, silicon revision, UID, clocks, reset cause
    - newlib syscalls with a failing _sbrk (no-heap policy)
    - board_panic() for unrecoverable init failures; debounced button events
    * docs(readme): rewrite as project overview with architecture, design and status
2026-10-18 ci: build Debug and Release firmware, report size, check formatting (#4)
    - GitHub Actions workflow on pushes and PRs to main/develop
    - Arm GNU Toolchain 15.2.Rel1 pinned to match local builds
    - Firmware .elf/.bin/.hex/.map uploaded as build artifacts
    - clang-format pinned to 23.1.1; scripts/check-format.sh for local use
    - VS Code Cortex-Debug launch and build tasks, PR template
    - Design notes: build system, memory layout, boot sequence, clock tree
2026-10-18 docs: rewrite README and design docs for a non-specialist audience (#5)
    - README explains the project in plain language: what the device does,
    highlights, how it works, the three ways to use it, skills demonstrated,
    and an honest status table
    - New hardware doc: parts, car wiring rules, pin map, clock and CAN timing
    - Design docs open with a plain-language summary and a glossary, with the
    engineering detail below
2026-10-18 test: unit-test framework, ring buffer, 100% MC/DC coverage gate and reports (#6)
    - Portable core library (lib/) shared by firmware and host tests
    - Lock-free SPSC byte ring buffer with C11 acquire/release ordering and a
    zero-copy peek/consume API for DMA
    - Unity tests registered one CTest test per case (UNIT_TEST wrapper applies
    Unity's name filter); a filter matching nothing fails the test
    - Presets: host-tests (ASan + UBSan), host-tests-tsan (ThreadSanitizer),
    host-coverage (Clang source-based coverage with MC/DC)
    - scripts/coverage.py: HTML/text/JSON reports, fails below 100% lines,
    functions, regions, branches or MC/DC
    - scripts/build_report_site.py: test and coverage report sit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
2026-10-18 feat(cli): portable line editor and command parser (#7)
    * feat(cli): portable line editor and command parser
    - line_editor: collects typed bytes into a line; backspace/delete, Ctrl-C,
    CR, LF and CR LF line endings, overflow handling; tells the caller what to
    echo. Bytes are compared as unsigned char so behaviour is identical on
    hosts (signed char) and Arm (unsigned char)
    - cli: tokenizer, case-insensitive command table lookup with argument-count
    checks, dispatch with context pointer, status strings, and a strict
    decimal/hex u32 parser with overflow detection
    - 30 new unit tests; core library remains at 100% MC/DC
    * fix(scripts): format check includes uncommitted files; apply form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
2026-10-18 feat(fault): CRC-16 and crash record sealing and decoding (#8)
    - crc16: CRC-16/CCITT-FALSE, bitwise (no table), incremental API; verified
    against the standard check value and an independent reference model
    - fault_record: crash record kept in reset-surviving RAM, sealed with a
    magic number and CRC so power-on garbage is never reported; decodes the
    Cortex-M4 CFSR/HFSR bits into a readable cause and identifies which
    address register (BFAR/MMFAR) holds the faulting address
    - 16 new unit tests; core library remains at 100% MC/DC
2026-10-18 feat(misra): MISRA C:2012 compliance check in CI with published report (#9)
    - scripts/misra.py runs cppcheck's MISRA addon on project code (lib/,
    firmware/) for the 32-bit Arm target and classifies every finding as
    open, deviated, disapplied or a documented false positive; fails on any
    open finding, unknown or misapplied deviation tag, or an attempt to
    deviate a mandatory rule; self-tests on a known-bad snippet first so a
    misconfigured run cannot pass silently
    - misra/config.toml: scope, 4 disapplied advisory rules with rationale,
    3 deviations (DEV-01 console printf, DEV-02 ST HAL macros, DEV-03 newlib
    syscalls) with risk controls, 1 tool false positive (FP-01)
    - Code brought i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
2026-10-18 docs: getting-started guide and one-command CMake workflow presets (#10)
    - docs/getting-started.md: hardware, tool installation on macOS, Linux and
    Windows, cloning with submodules, building, three ways to flash
    (drag-and-drop, OpenOCD, STM32CubeProgrammer), viewing the serial output,
    running tests, debugging, and a troubleshooting table
    - CMake workflow presets: `cmake --workflow --preset firmware` configures
    and builds in one step; `--preset host-tests` also runs the unit tests
    - README quick start uses the workflow preset, documents drag-and-drop
    flashing, and links to the full guide
2026-10-18 feat(console): portable console core with interactive and host modes (#11)
    - console_core: feeds received bytes through the line editor, echoes and
    edits in interactive mode, runs commands from a cli table, and reports
    results; all output goes through a write callback
    - Interactive mode: prompt, echo, backspace, Ctrl-C, aligned label/value
    rows, readable errors with usage hints
    - Host mode for the laptop tool: no echo or prompt, key=value data lines,
    every reply ends with OK or ERR <reason>, events prefixed with '!'
    - Events (e.g. button presses) redraw the prompt and partial input
    - Built-in help listing and per-command usage
    - 25 unit tests; core library stays at 100% MC/DC and MIS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
2026-10-18 feat(firmware): interrupt/DMA serial driver and console commands (#12)
    - uart_link: USART2 receive interrupt into a lock-free ring buffer; DMA1
    stream 6 transmits from a second ring buffer in contiguous blocks and
    chains the next block from its completion interrupt, so the CPU never
    waits on the serial port; critical section guards the start-transfer
    race; bounded back-pressure with drop counting; flush for clean resets;
    receive/transmit statistics
    - console: connects the portable console core to the serial link;
    printf-style output and key/value fields through fixed buffers
    - Commands: help, version, status, led on|off|auto, mode
    interactive|host, reset (reply is flushed befor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
2026-10-18 feat(firmware): watchdog and crash capture (#13)
    - Independent watchdog (500 ms nominal, LSI-clocked), refreshed every main
    loop pass, paused while a debugger halts the core
    - Separate MemManage/BusFault/UsageFault handlers and divide-by-zero trap
    - Fault entry in assembly (fault_entry.S, MISRA Dir 4.3): finds the stacked
    frame from EXC_RETURN, switches to a dedicated fault stack so capture
    survives stack overflow, then calls fault_capture()
    - fault_capture() stores registers and CFSR/HFSR/MMFAR/BFAR in a sealed
    .noinit record and resets; the next boot validates it, reports the crash
    in the start-up report and via `fault`, and clears it
    - `fault [clear]` command; status reports wat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
2026-10-19 fix: serial flush could return before the last bytes were sent; doc corrections (#14)
    Firmware:
    - uart_link_flush() relies on the USART transmission-complete (TC) flag,
    which was never cleared, so it could report "sent" while the final 1-2
    bytes were still shifting out; `reset` could then truncate its own OK
    reply. TC is now cleared before every DMA transfer, as the reference
    manual specifies for DMA transmission
    - uart_tx_bytes counted blocks that ended in a DMA error as sent; now only
    completed transfers are counted, matching the documentation
    Docs (found in a full review against the code):
    - build-and-boot: start-up sequence now includes crash pickup, the serial
    interrupt/DMA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
2026-10-19 feat(host): obdsniff laptop tool with CLI, shell and board simulator (#15)
    - Device: protocol client for the board's host mode: reliable connect from
    any console state, commands with OK/ERR handling, key=value parsing,
    events collected wherever they arrive (including a non-blocking poll),
    stale reply lines discarded before each command, reset and crash with
    reconnect, clear errors for missing boards and unusable ports; closing
    hands the console back in interactive mode
    - Simulator: software model of the firmware console (same commands, keys,
    labels, help, errors, editing and start-up report) behind --port sim; a
    test fails if it drifts from firmware/src/commands.c
    - CLI: ports,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
2026-10-19 fix(console): reject over-long lines instead of running them cut short (#16)
    A line longer than 96 characters had its extra bytes dropped, and the
    shortened line then ran as a command. In host mode this happened silently;
    interactive mode rang the bell but still ran it on Enter. That is harmless
    with today's commands but must never happen once commands transmit on the
    CAN bus. The line editor now remembers that bytes were dropped and, when
    the line ends, reports LE_TOO_LONG instead of a line; the console replies
    `ERR line too long` / `error: line too long` and runs nothing. Ctrl-C
    starts over; backspace does not rescue an overflowed line.
    Also fixes two alignment flaws seen on the board:
    -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
2026-10-19 docs: record the first hardware check of the board (#17)
    README status rows for start-up, serial console, watchdog and crash
    capture, and the laptop tool change from "awaiting hardware check" to
    "verified on hardware". testing.md gains a "Checks on the board"
    section: what was checked on the NUCLEO-F446RE, the measured results
    (clock accuracy, watchdog timeout), and the three problems the check
    found.
2026-10-19 feat(host): desktop app with board info, LED control and console (#18)
    `obdsniff gui` opens a PySide6 window built on the same Device library as
    the command line:
    - port picker (the Nucleo is found and preselected; the simulator is
    always offered), connect and disconnect
    - board panel: version, status and last crash, refreshed after every
    action; LED on/off/auto; restart; clear crash record
    - console pane: any board command, replies formatted as in the shell,
    events such as button presses shown as they happen
    The board connection runs in a DeviceWorker on its own QThread and talks
    to the window only through queued signals, so the window stays responsive
    while the board restarts. On ex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
2026-10-19 chore(release): prepare v0.2.0 (#19)
    - CMake project version 0.2.0 (reported when built without git history)
    - getting-started: ready-made firmware is attached to each release
2026-10-19 fix(host): simulator reports a crash once, like the firmware (#21)
    The firmware's fault_init() reads the crash record at the next start-up
    and clears it, so any later restart (reset, watchdog) reports no crash.
    The simulator kept the crash until 'fault clear', so the laptop tool could
    be tested against behaviour the board doesn't have. A crash now leaves a
    record for the next start-up only, which picks it up and forgets it.
2026-10-19 docs: corrections from a full repo review (#23)
    - protocol.md: library paths are lib/src/...; a crash is reported after
    the restart it caused and forgotten after the next one
    - fault-handling.md: example output and addr2line taken from the board
    (current column layout, real addresses)
    - build-and-boot.md: the compiled HAL modules are listed in
    firmware/CMakeLists.txt and enabled in stm32f4xx_hal_conf.h; version
    example v0.2.0
    - getting-started.md: start-up report shows v0.2.0; troubleshooting for a
    console left in host mode
    - misra.md: the check needs Python 3.11+
    - README: release badge and ready-made firmware downloads; the laptop tool
    includes the desktop app
    - host/README: co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
2026-10-19 fix(console): commands sent in a burst restarted the board or lost replies (#24)
    Found by a stress test on the board: 20 commands sent without waiting for
    replies, at 115200 baud.
    - console_poll() processed all received input in one pass of the main
    loop. The burst's replies (14 KB) took over a second to send, longer
    than the watchdog allows, and the board restarted. It now runs at most
    one command per pass; console_core_feed() reports when a line has ended.
    - With that fixed, replies were partly dropped (uart_tx_dropped): DMA
    transfers covered up to the whole 2 KB buffer, whose space is released
    only when a transfer completes, about 180 ms later at 115200 baud, while
    a writer w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
2026-10-19 feat(link): 1.5 Mbaud serial link (#26)
    The serial link goes from 115200 to 1,500,000 baud, so that phase 3 can
    stream CAN frames from a fully loaded bus: a 25-byte frame packet gives
    about 5,900 frames/s against at most about 4,500 on a 500 kbit/s bus.
    Chosen by measurement on the board: every speed the 45 MHz UART clock
    divides exactly, stress-tested with bursts of commands and byte-for-byte
    reply checks. All had zero errors and about 99% of the line rate;
    1.5 Mbaud (148 kB/s) is exact and a standard Linux terminal speed,
    unlike 2.25 Mbaud.
    - firmware: UART_LINK_BAUD 1500000; receive buffer 1 KB (about 7 ms of
    input), transmit buffer 4 KB (replies plus streamed data)
    - laptop tool: mat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
2026-10-19 feat(lib): portable CAN building blocks (#27)
    Hardware-independent pieces for CAN capture, unit-tested on the host to
    100% MC/DC and checked against MISRA C:2012 (0 open findings):
    - can_frame.h: a captured frame (timestamp, 11/29-bit id, dlc, flags,
    data)
    - frame_queue: lock-free single-producer/single-consumer queue of frames
    for the receive interrupt and the main loop, built on the existing
    ring buffer; frames are stored and published whole. Two-thread stress
    test under ThreadSanitizer.
    - cobs: Consistent Overhead Byte Stuffing, canonical encoding; tested
    with the published reference examples, full-block edge cases and
    malformed input
    - packet: CAN frame packet for the binary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
2026-10-19 feat(host): decode binary frame packets mixed into the console output (#28)
    Groundwork for CAN capture: in host mode the board will send captured
    frames as binary packets (0x00 | COBS(...) | 0x00) between its text
    lines. The laptop tool now separates them as soon as bytes are read, so
    replies, events, prompt detection and crash/reset handling only ever see
    text. Harmless with the current firmware, which sends no packets yet.
    - packets.py: CRC-16, COBS, CanFrame, frame packet encode (for the
    simulator) and decode, mirroring lib/src/cobs.c and lib/src/packet.c;
    tested against the same golden vectors as the C code
    - StreamSplitter: gets back in step after a lost byte (two zeros in a
    row;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
2026-10-19 feat(firmware): CAN1 loopback capture, test traffic and the can command (#29)
    The board now captures CAN frames and streams them to the laptop. Built
    and verified entirely on the Nucleo using the controller's silent
    loopback, in which sent frames are received internally and nothing
    reaches the pins.
    - timebase: TIM2 free-running at 1 MHz (32-bit) for frame timestamps;
    DWT cycle counter for timing code
    - can_drv: CAN1 on PB8/PB9, bit timing from lib/can_timing, accept-all
    filter, RX FIFO0 interrupt at the highest priority that timestamps each
    frame, gives it a capture number (counted even if the frame is then
    dropped, so a gap on the laptop means a lost frame) and queues it in
    lib/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
2026-10-19 feat(host): CAN in the command line, shell and desktop app (#30)
    - Device: can_status(), can_loopback(), can_off(), can_send(), can_test()
    - obdsniff can [loopback|off|send|test]: `can test` runs a numbered
    series in loopback and checks every frame arrived, in order and
    undamaged; reports bus rate and frame spacing from the board's
    timestamps; exit code 1 on any problem
    - obdsniff monitor: CAN frames as well as events, written in batches so
    thousands of frames a second keep up; --json lines; --log FILE in
    candump format (can-utils, SavvyCAN); reports frames lost (capture
    number gaps) and damaged packets at the end
    - shell: frames received since the last prompt (summarised above 2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
2026-10-19 docs: CAN capture design and measured results (#31)
    - docs/design/can-capture.md: the path of a frame from the controller to
    the laptop (interrupt, timestamps, lock-free queue, capture numbers,
    packets, flow control, the laptop's splitter, test traffic), layered
    for non-specialists, with the measured results
    - README: CAN capture status (done, tested in loopback, verified on
    hardware), measured headline, CAN tab screenshot, new doc in the list
    - testing.md: serial-link stress test, CAN capture and CAN tool checks,
    and the problems the board checks found during phase 3
2026-10-19 feat(scripts): scripted board check, also run against the simulator in CI (#34)
    The hardware checks behind docs/design/testing.md lived in throwaway
    scripts outside the repo, so the measured results could not be
    repeated. scripts/board_check.py runs them through the obdsniff library
    and prints one line per check with the number it measured:
    - identity, clock source and speed, watchdog setting
    - board clock against the laptop's (ppm)
    - 100 commands in one write: every reply arrives, nothing dropped,
    no restart (console flow control)
    - with CAN off, transmit commands are refused
    - loopback capture at 500 and 250 kbit/s: every frame checked, and the
    frame rate shows the bus was full
    - 1 Mb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
2026-10-19 docs: correct stale bit-timing and buffer-size values (#35)
    - build-and-boot.md gave 500 kbit/s as prescaler 5 with 18 time quanta.
    The bit-timing calculator picks prescaler 6 with 15 quanta (86.7%,
    closer to the 87.5% target than 18 quanta's 88.9%), as hardware.md,
    can-capture.md and the unit tests already say.
    - The serial-console.md data-flow diagram still showed the receive and
    transmit buffers at 256 and 2048 bytes; they are 1024 and 4096.
2026-10-19 feat(lib): ISO-TP transport for messages longer than one CAN frame (#37)
    OBD2 replies such as the VIN (20 bytes) don't fit in one 8-byte CAN
    frame. ISO-TP (ISO 15765-2) splits them into a first frame and numbered
    consecutive frames, paced by the receiver's flow control.
    lib/src/isotp.c has a receiver and a sender, each a small state machine
    with no waiting: the caller passes in received frames and polls with the
    time. A frame to transmit is handed out by poll and only counted once the
    caller confirms it was accepted (the standard's transmit confirmation), so
    a full CAN mailbox delays a transfer instead of losing a frame.
    Covered: single, first, consecutive and flow-control frames; block si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
2026-10-19 feat(lib): OBD2 message decoding and a simulated ECU (#38)
    lib/src/obd2.c turns OBD2 replies (SAE J1979) into numbers and text:
    - seven current-data PIDs: engine speed, vehicle speed, throttle, engine
    load, coolant and intake temperature, engine run time; values are
    integers scaled by 10^decimals (throttle 23.5% is 235), so the firmware
    needs no floating point
    - monitor status: warning light and number of stored trouble codes
    - stored trouble codes (service 03) and their text form (P0301)
    - the VIN (service 09 PID 02)
    - the reverse direction too, numbers into reply bytes, clamped to what
    each PID can express
    lib/src/ecu_sim.c is an engine control unit to talk to without a car. Its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
2026-10-20 feat(lib): OBD client and the simulated ECU as a bus node (#39)
    lib/src/obd_client.c is the diagnostic tester. It works through a fixed
    plan, one request at a time: the VIN until it has one, the stored trouble
    codes and monitor status every 5 s, and otherwise each live-data PID in
    turn, with a 10 ms gap between a reply and the next request. A reply must
    start within 50 ms (ISO 15765-4); once a multi-frame reply has begun,
    ISO-TP times the rest. It keeps the latest values, codes, warning light
    and VIN, and counts requests, replies, timeouts and errors.
    lib/src/ecu_node.c puts the simulated ECU on the bus: ISO-TP around
    ecu_sim, taking requests on 0x7DF and 0x7E0 and replying from 0x7E8.
    Bot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
2026-10-20 feat(can): switch frame streaming on and off (#40)
    `can stream on|off` decides whether received frames are sent to the
    terminal or the laptop. Off, the board still receives, counts and
    dequeues them (so nothing is counted as dropped) but sends nothing. A
    person in a serial terminal can then keep the console readable while the
    board is busy with other traffic, such as the OBD2 requests coming next.
    - firmware: can_stream_enable(); on after every start-up; a `can_stream`
    field in `can` status
    - simulator: the same command and field (the parity test checks both)
    - laptop tool: `obdsniff can stream on|off`; `monitor` and `can test`
    switch it on, since they need the frames; Device.can_stream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
2026-10-20 fix(scripts): two board checks that could fail on a working board (#41)
    Two board checks added in #34 could fail while the board was working
    correctly.
    - Overload at 1 Mbit/s: a gap in the capture numbers only shows once a
    later frame arrives, so frames dropped at the end of the burst left
    none, and the check failed about a third of the time on the board.
    The test frames are numbered from 0, so losses after the last frame
    received are now counted separately and reported. can-capture.md
    describes the limit, which any numbering scheme has.
    - Command burst: "uptime went up" was taken as proof of no restart, but
    the simulator answers the whole burst within a millisecond, so on a
    f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
2026-10-20 feat(firmware): OBD2 tester and simulated engine ECU over loopback (#42)
    The board now talks OBD2. In loopback it runs both sides: the tester
    (lib/obd_client) asks for live data, the stored trouble codes and the
    VIN, and a simulated engine ECU (lib/ecu_node) answers, all through the
    real CAN controller. The frames are captured and streamed like any
    others.
    - can_drv: OBD2 frames (to 0x7DF and 0x7E0, from 0x7E8) also go into a
    second, small queue, so the tester and the ECU get them at once even
    while the stream to the laptop is backed up or switched off. Each
    queue keeps one producer and one consumer.
    - obd.c: the main-loop task that routes those frames and sends what the
    two nodes h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
2026-10-20 feat(host): OBD2 in the command line and desktop app (#43)
    The board's OBD2 tester (#42) is now usable from the laptop, the last of
    the three ways in:
    - `obdsniff obd`: the tester's latest answers; `obd start|stop`.
    - `obdsniff obd watch`: a live view. It starts loopback and the tester
    if needed, switches frame streaming off while it runs (the values
    matter here, not about 200 frames a second) and puts streaming back as
    it found it on exit. In a terminal it redraws in place; otherwise, or
    with --json, it prints one update after another.
    - Desktop app: an OBD2 tab with the live values, the warning light (in
    red when on), trouble codes, VIN and counters. Start also starts CAN
    loop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
2026-10-20 docs: OBD2 design, results and how to try it (#44)
    - docs/design/obd2.md: what OBD2 asks and how; the VIN conversation
    frame by frame; the layers in lib/; state machines that never wait and
    confirm each frame sent; the timing limits and where they come from;
    the second receive queue and its cost (7 to 10 us in the interrupt);
    values without floating point; the simulated ECU; measured results.
    - README: OBD2 status row done and verified on hardware; the simulated
    engine computer in loopback; the new ways in (obdsniff obd watch, the
    desktop app's OBD2 tab); link to the design doc.
    - getting-started: trying OBD2 in a terminal and with obdsniff.
2026-10-20 chore(release): prepare v0.4.0 (#45)
    - CMake project version 0.4.0 (reported when built without git history)
    - laptop tool version 0.4.0
    - getting-started: the sample start-up report shows the current version
2026-10-20 fix(firmware): commands lost bytes while CAN traffic ran (#46)
    With OBD2 running, about one command in 200 from the desktop app was
    rejected as an unknown command. The board counted receive overruns, but
    only while CAN traffic ran: at 1.5 Mbaud the UART holds one received
    byte for 6.7 us, and the CAN receive interrupt, which had the higher
    priority, can run for 7 to 10 us. A byte that arrived meanwhile was
    lost.
    Interrupt priorities now follow deadlines. The serial receive interrupt
    comes first (priority 0): its handler takes well under a microsecond.
    The CAN interrupt (priority 1) has a 3-frame hardware FIFO and can wait
    about 90 us even on a full 1 Mbit/s bus.
    On the board, 20 s of comma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
2026-10-20 docs: screenshot of the desktop app's OBD2 tab on the board (#47)
    Taken against the board, not the simulator: live values from the
    simulated engine computer, the warning light, both trouble codes and the
    VIN, with 592 requests answered and none timed out.
2026-10-20 docs: correct the 1 Mbit/s overload numbers (#49)
    The table paired about 17,140 frames received with a bus rate of about
    8,400 per second, which the 1.5 Mbaud link (about 6,000 frames/s) can't
    deliver together. Measured again before the v0.4.0 release:
    - the test traffic comes from the same main loop that streams it, and
    only the Release build keeps a 1 Mbit/s bus full while streaming:
    8,411 frames/s, 14,790 received, 5,210 dropped (3 runs, identical
    within one frame)
    - the Debug build reaches about 7,060 frames/s while streaming, which is
    where the old received count came from
    The row now shows the Release build, and the text explains the
    difference and the longer gaps in the spac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
2026-10-28 refactor: group the C code and the simulator by subsystem (#51)
    Replace the flat src/ and include/ folders with module folders: each .c
    beside its .h, includes naming the folder ("obd/isotp.h").
    lib/ buffers can link console obd fault
    firmware/ system hal console can obd fault linker
    tests/ mirrors lib/
    host/src/obdsniff/sim/ board.py, can.py, obd.py (were simulator.py,
    sim_can.py, sim_obd.py)
    firmware/hal holds only ST's HAL glue and is the only project folder on
    the HAL's SYSTEM include path. The MISRA scope is lib and firmware,
    searched recursively with third_party excluded, so a new subsystem
    folder is analysed without a config change. CTest names are unchanged.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
2026-10-28 ci: analyse MISRA files in parallel (#52)
    Each firmware file includes all of ST's HAL and device headers, so
    cppcheck spends about 20 s on it (a 121 MB dump for a 53-line file),
    and the 18 firmware files were analysed one after another. Pass -j with
    one job per core (--jobs to override). The findings are unchanged.
2026-10-28 docs: describe what is built today (#53)
    The README described planned features as if they existed: a safety
    layer with an FMEA and fault injection, sleep mode, live graphs, and a
    car connection through a transceiver. Rewrite the highlights, the
    diagram, the skills table and the hardware list to cover only what is
    built and measured; planned work stays in the status table.
    Add a "Measured on the board" table and a repository layout table.
    hardware.md and testing.md get the same corrections. Use cu.usbmodem
    for macOS ports, and list every CI gate in the PR template.
2026-10-28 test: board check covers OBD2 (#54)
    Run the board's OBD2 tester against its simulated engine ECU and check
    that every request is answered in time, every live value is read, and
    the multi-frame VIN and both trouble codes are right. The expected
    values come from the simulator, which test_matches_firmware.py keeps in
    step with the C code. Runs before the interrupt-time check, so OBD2
    traffic is included in the longest receive interrupt.
    testing.md: today's full board check output (Debug build, --crash), how
    the Release build differs, measured run times, and the #46 link.
2026-10-28 docs: screenshots from v0.4.0, and the script that takes them (#55)
    The console screenshot predated the tabs, and all three showed a commit
    hash instead of a version. Retake them from the v0.4.0 tag: the console
    from the Debug build (crash bus is debug-only), the CAN and OBD2 tabs
    from the Release build.
    scripts/screenshots.py drives the real window against the board and
    waits for each expected state with a deadline instead of fixed delays.
2026-10-29 docs: board check results for v0.4.1 (#59)
    testing.md quotes the board check of the tagged v0.4.1 builds (28 October 2026) and says which checks by hand were repeated for v0.4.1.
2026-10-30 ci: build the release files from the tag (#60)
    Pushing a vX.Y.Z tag builds both firmware builds in CI, checks the versions match the tag, and attaches the files and SHA256SUMS.txt to a draft release. scripts/release_check.py compares them with the local build checked on the board before the draft is published. A manual run builds an existing tag into a workflow artifact only.
2026-10-30 ci: check the firmware's worst-case stack use (#61)
    scripts/stack_usage.py works out the firmware's worst-case stack use from the linked ELF: the start-up code and main loop plus every exception handler nested with its 108-byte exception frame must fit the 8 KiB reserved stack, and the crash capture its 512-byte fault stack. It fails on recursion, an unsized stack-pointer change, or an unreviewed function-pointer call, and cross-checks every frame against GCC's -fstack-usage. Release 2,544 and Debug 2,764 of 8,192 bytes.
2026-10-30 fix: compare release files by symbols, and board-check CI's own files (#62)
    CI's release files can't be byte-identical to a laptop build (separately built C libraries on macOS and Linux place newlib's functions in a different order). release_check.py now checks the .bin is the .elf's image and the .elf's symbols, sizes and section sizes match the local tagged build, keeps the files in build/release/vX.Y.Z, and --flash loads them for board_check.py.
2026-11-01 docs: requirements, read-only safety concept and circuit board design (#63)
    Writes down the circuit board direction before any of it is built: requirements.md (numbered requirements with pass criteria and honest status), safety.md (the read-only design, four safety layers, residual risks as a first FMEA, the order of car tests), architecture.md (a one-page map of the firmware as it is today) and circuit-board.md (each block of the board and why it is there). README, hardware.md, obd2.md and getting-started.md link to them; the project status lists the new stages.
2026-11-01 refactor: remove the led command (#64)
    The green LED always shows the heartbeat. Removed the led board command, the LED status field, obdsniff led, Device.set_led, the desktop app's LED buttons and the simulator's LED; tests use fault and can as sample commands instead.
    Also fixes a crash of the desktop app on exit on Linux, which this change exposed: gui.run() now deletes the window while the application still exists, instead of leaving it to Python's exit, when Qt is already gone.
    Flash: Debug 36,412 -> 36,120 bytes, Release 26,968 -> 26,704.
2026-11-01 docs: refresh the desktop app screenshots (#65)
    Retakes the desktop app screenshots on the board with develop at 0b46568 (the LED buttons are gone). The CAN caption no longer quotes the app's once-a-second rate display. Board check of 0b46568: Debug 18 of 18, Release 14 of 14.
2026-11-01 refactor: remove can send (#67)
    A car tool has no reason to send a frame typed by hand, and it was the one command that could put any frame on the bus. Removed the can send board command, its hex parsers in lib/console and the ID limits only it used, obdsniff can send, Device.can_send and the simulator's can send. board_check.py's CAN safety check now also confirms can send is gone. Also drops the obdsniff led line #64 missed in host/README.md.
    Board check: Debug 18 of 18, Release 14 of 14. Flash: Debug 36,116 -> 35,668 bytes, Release 26,700 -> 26,412.
2026-11-02 refactor: remove the interactive console (#68)
    The board now speaks one protocol, the one made for the laptop tool, and formats nothing for people; the laptop does all the presenting. Removed interactive mode and the mode command, the prompt, echo and line editing (the line editor becomes a plain line reader), field labels on the board and in the PID table, and the text form of CAN frames. The start-up report ends with the event !started, which the laptop waits for after a reset or crash. screenshots.py deletes its window while the application still exists. Docs and screenshots updated.
    Board check: Debug 18 of 18, Release 14 of 14. Flash: Debug 35,668 -> 32,500 bytes, Release 26,412 -> 24,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
2026-11-02 feat: transmit guard (#69)
    Every frame the board sends passes lib/obd/tx_guard.c: only OBD2 read requests to 0x7DF (01 for the table's PIDs and 00/01, 03, 09 02) as 8-byte single frames with 11-bit IDs, at most one every 50 ms, plus ISO-TP continue/overflow flow control to 0x7E0-0x7E7. Everything else is refused and counted (can_tx_refused). Unit-tested to 100% MC/DC. can_drv_send() is the guarded path; can_drv_send_loopback() carries test traffic and the simulated ECU's replies, in loopback only. The tester waits 50 ms after each reply.
    Board check: Debug 18 of 18, Release 14 of 14; OBD2 199 requests in 10 s, 0 refused.
2026-11-02 feat: the board asks only what the laptop asks (#70)
    The board's OBD2 tester no longer runs a plan of its own: obd start/stop are replaced by obd ask <what> (vin, codes, status, or a live value), which sends exactly one request through the transmit guard. One question at a time, at least 50 ms apart; if the laptop stops asking, the board stops sending. The plan moved to the laptop (host/src/obdsniff/obdplan.py), used by obd watch, the desktop app, board_check.py and screenshots.py. board_check.py also checks that nothing is sent once the laptop stops asking.
    Board check: Debug 18 of 18, Release 14 of 14; OBD2 201 requests in 10 s, 0 refused, then silent.
2026-11-02 feat: 168 MHz clock, and no fallback to the internal oscillator (#71)
    168 MHz is the fastest speed whose PLL also gives USB its exact 48 MHz, and it needs no over-drive mode. APB1 is now 42 MHz; CAN bit timing and 1.5 Mbaud still divide exactly. The fallback to the internal 16 MHz oscillator is gone: a board without its external clock stops in board_panic() instead of running with timing it can't trust. Docs, simulator, board check and screenshots updated.
    Board check: Debug 18 of 18, Release 14 of 14.
2026-11-02 chore(release): prepare v0.5.0 (#72)
    Bumps the version to 0.5.0 in CMakeLists.txt, host/pyproject.toml, obdsniff.__version__ and the sample start-up report.
2026-11-02 docs: board check results for v0.5.0 (#75)
    Records the v0.5.0 board checks on CI's own release files (Debug 18 of 18, Release 14 of 14) in testing.md, notes which manual checks were repeated, and updates the README's results table to the v0.5.0 figures.
2026-11-03 docs: animated demo of the desktop app, and screenshots from v0.5.0 (#76)
    screenshots.py gains a demo shot that records the desktop app's OBD2 tab on the board as docs/images/desktop-app-demo.gif; only that shot needs Pillow. All images are retaken from CI's v0.5.0 Debug file.
2026-11-03 docs: rework getting started into three levels (#79)
    Reworks getting-started.md into three levels, each ending with what you should see: try it with no hardware, a real board with ready-made firmware, then build from source. It says plainly that the project doesn't connect to a car yet, corrects the board's USB drive name (NOD_F446RE or NODE_F446RE, depending on the ST-LINK version), and adds troubleshooting for the laptop tool's own errors. Not yet tested: a clean pip install, the drag-and-drop copy, and a fresh Level 3 build.
2026-11-03 docs: accuracy, neutral voice and diagrams across the design documents (#81)
    Safety no longer says the layers are proven on the bench or that the hardware switch exists. The remaining first-person passages are neutral, every document links back to the documentation map, and the OBD2 conversation, the path of a frame, the board's blocks and the safety layers are now diagrams. scripts/check_links.py, run in CI, fails if a link between the documents breaks.
2026-11-04 docs: make the first car session safe without the hardware switch (#82)
    Until the hardware LISTEN switch exists, listen-only car sessions have the transmit wire physically disconnected (SAF-10). safety.md adds a first step to check the car uses classic CAN, and records as an open question whether switching the CAN controller's mode can lose frames. hardware.md no longer says a wiring mistake can't damage anything. requirements.md quotes the v0.5.0 figures.
2026-11-05 docs: set up the hardware folder for the KiCad design (#84)
    docs: set up the hardware folder for the KiCad design
    Add hardware/ with a guide, a working brief for revision A and a place
    for shared libraries. No KiCad files yet: the design hasn't been started.
    Ignore KiCad's local and generated files, include the new documents in
    the link check, and link them from the README and the documentation map.
2026-11-12 docs: power the circuit board from USB only, and record the part choices (#85)
    docs: power the circuit board from USB only, and record the part choices
    The board only works with a laptop attached, and the laptop's USB port
    supplies its power, so the car's 12 V supply no longer enters the board.
    The 12 V input chain, the battery-voltage reading and the sleep mode are
    removed from the design, along with requirements PWR-1 to 4, 6 and 7.
    PWR-8 is new: the board takes nothing from the car.
    The revision A brief now records the design decisions and the parts
    chosen so far, with the datasheet figures each one relies on. The
    self-test connection becomes CAR/TEST jumpers, so CAN2 can't reach the
    ca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
2026-11-12 feat(hardware): revision A schematic, USB and power sheet (#86)
    feat(hardware): revision A schematic, USB and power sheet
    Start the KiCad project for revision A with its first sheet: the USB-C
    socket with its CC resistors, ESD protection on the data pair, a 1 A
    fuse, the 3.3 V regulator and the PWR light, with test points on VBUS,
    5 V and 3.3 V.
    A PDF of the schematic is committed beside the KiCad files so it can be
    read without KiCad. The brief records the socket and fuse chosen and the
    5 V budget they were chosen against.
2026-11-13 feat(hardware): revision A schematic, microcontroller sheet (#87)
    feat(hardware): revision A schematic, microcontroller sheet
    Add the STM32F446RET6 with its supply decoupling, the single 4.7 uF
    core capacitor that LQFP64 needs, an 8 MHz crystal, reset and boot
    buttons with the pull-downs the USB bootloader needs, the SWD and debug
    serial headers and the BUS light. Unused pins are marked.
    The crystal is an ECS ECX-53B with a 10 pF load. Its start-up margin is
    worked out in the brief against the chip's limit.
2026-11-14 feat(hardware): revision A schematic, CAN sheet (#88)
    feat(hardware): revision A schematic, CAN sheet
    Add the last schematic sheet: two TJA1051T/3 transceivers, the shared
    silent signal with its pull-up, the LISTEN/OBD switch, the TX light
    switched by the silent signal through a transistor, the CAR/TEST
    jumpers, termination, ESD protection, the car connector and test
    points.
    The CAR/TEST jumpers are two separate 3-pin headers. A single 2 x 3
    block would let a jumper cap short the car's two CAN wires together.
    ERC on the whole schematic now passes with no errors and no warnings.
